chenshih881001/Life-Frog/Diagrams/Lifefrog Requirements Diagram.jpg

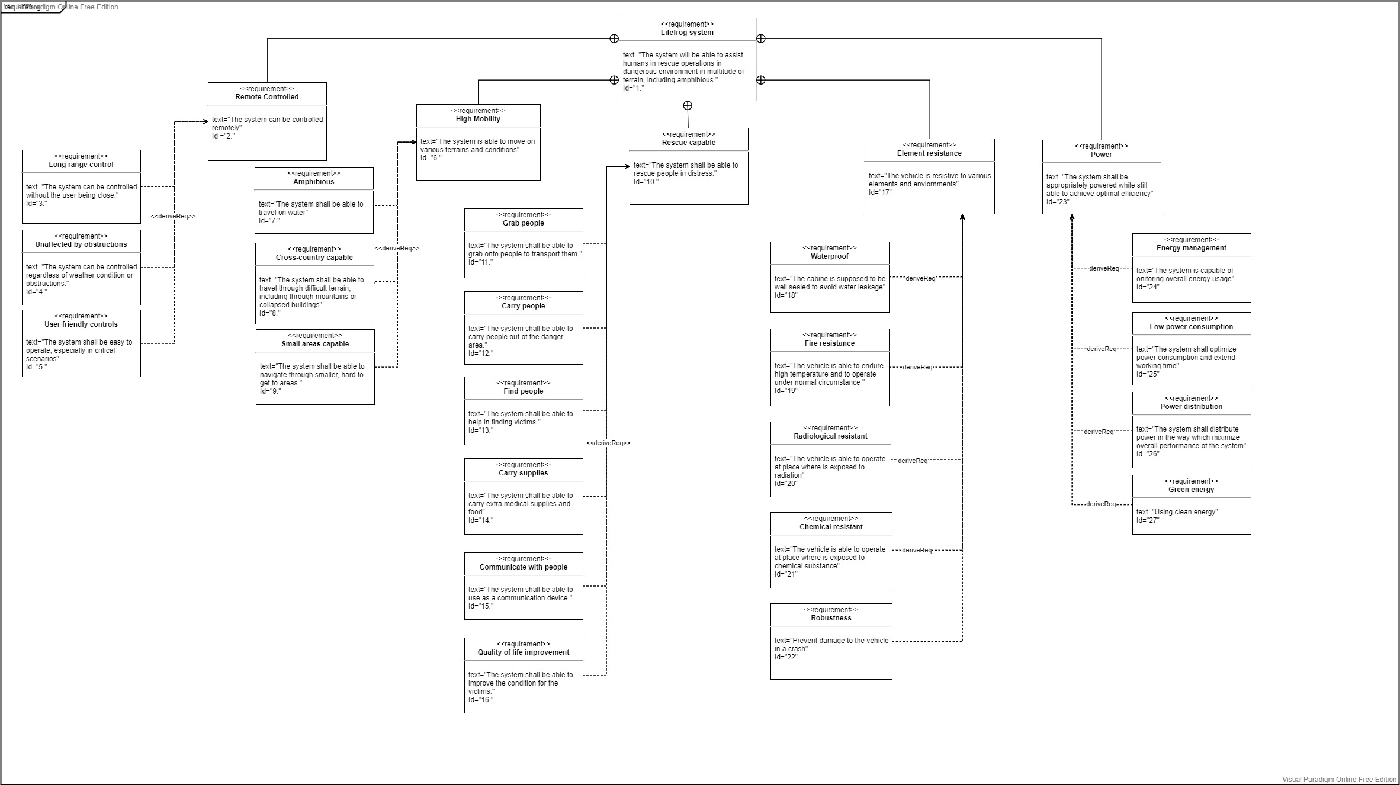
Diagrams/Lifefrog Requirements Diagram.jpg
