chenshih881001/Life-Frog/Diagrams/Lifefrog Sequence Diagram - Crane Control.png

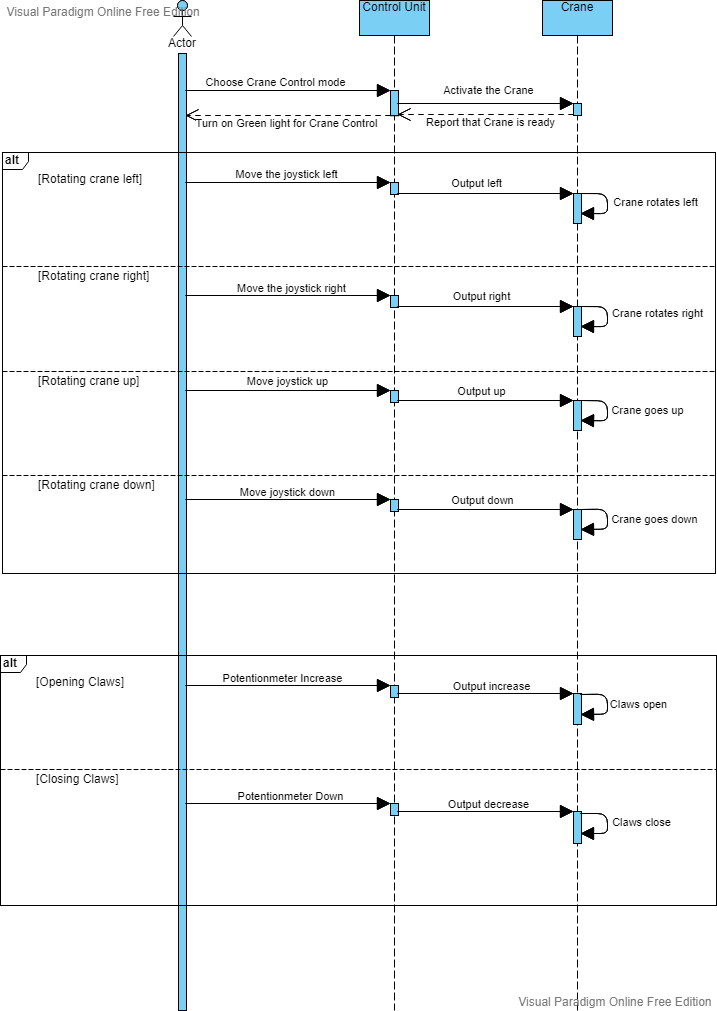
Diagrams/Lifefrog Sequence Diagram - Crane Control.png
