chenshih881001/Life-Frog/Diagrams/LifeFrog Sequence Diagram - Navigation.png

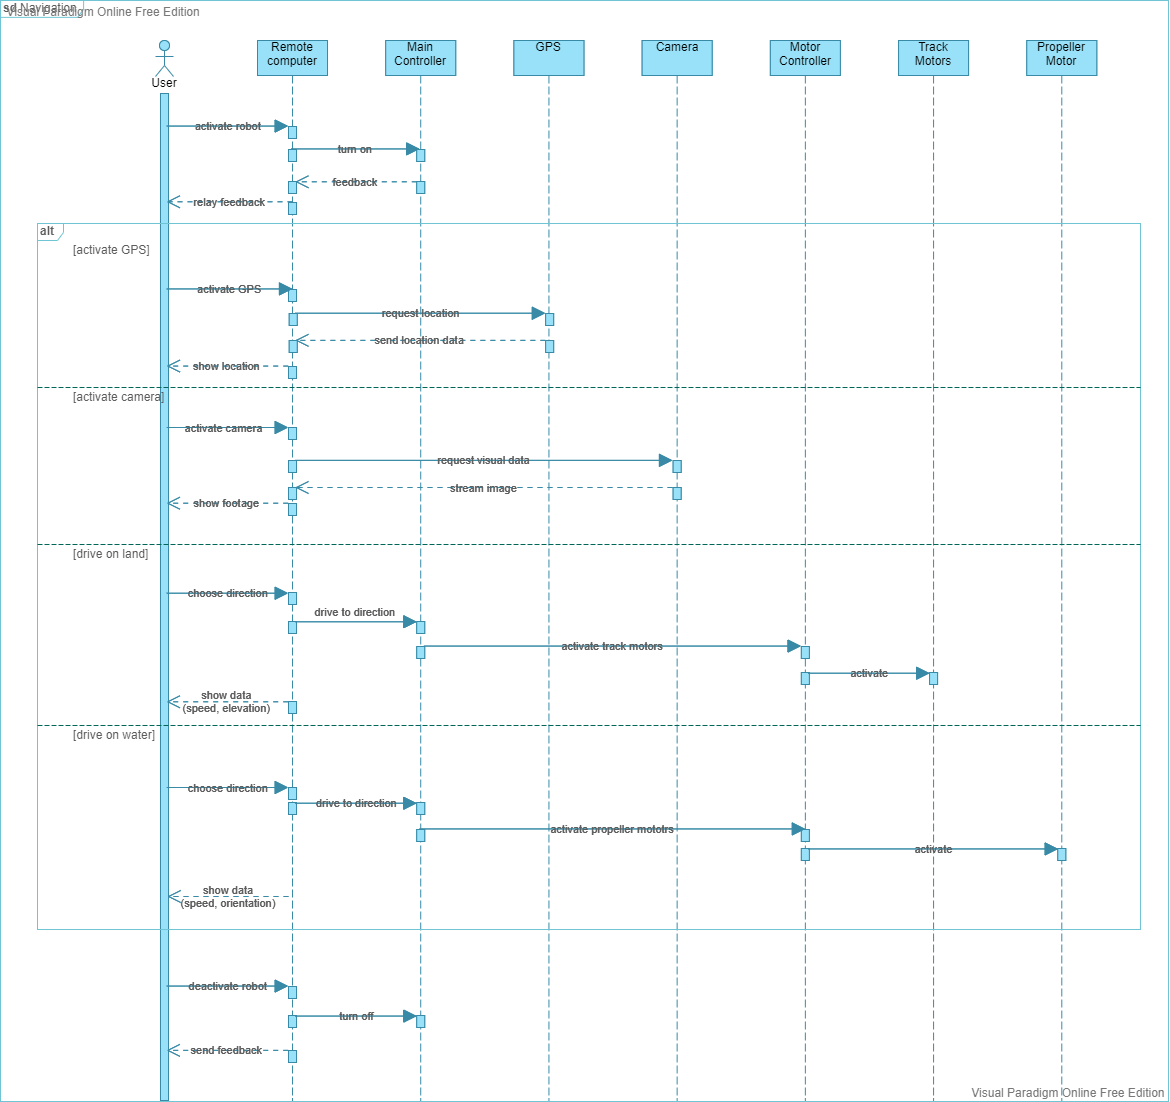
Diagrams/LifeFrog Sequence Diagram - Navigation.png
