chenshih881001/Life-Frog/Diagrams/Use-case Crane,ladders.png

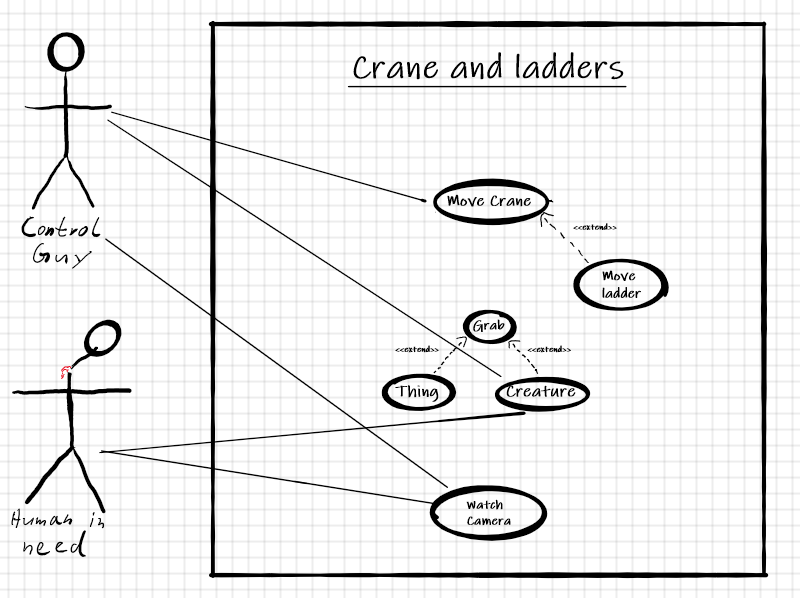
Diagrams/Use-case Crane,ladders.png
