chenshih881001/Life-Frog/Diagrams/Use-case Explorer robot.png

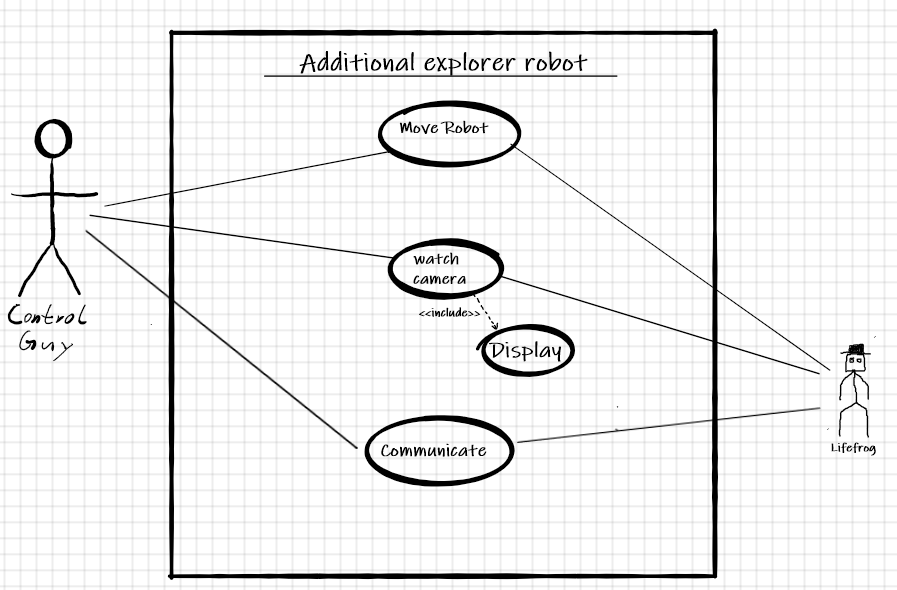
Diagrams/Use-case Explorer robot.png
