chenshih881001/Life-Frog/Diagrams/Use-case Remote control.png

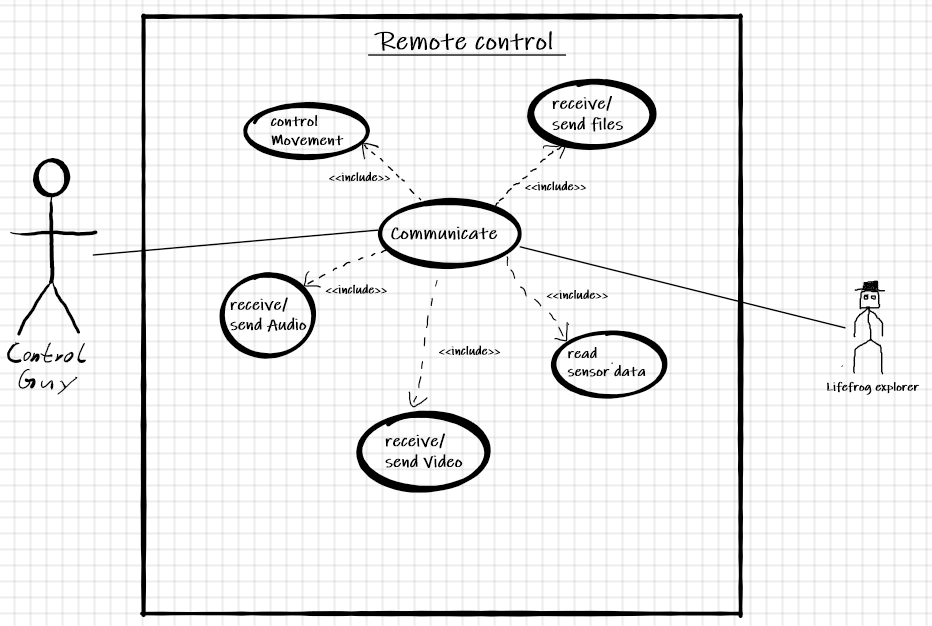
Diagrams/Use-case Remote control.png
