chenshih881001/Life-Frog/System engineering/Diagrams/Context diagram/LifeFrog - Block Diagram.png

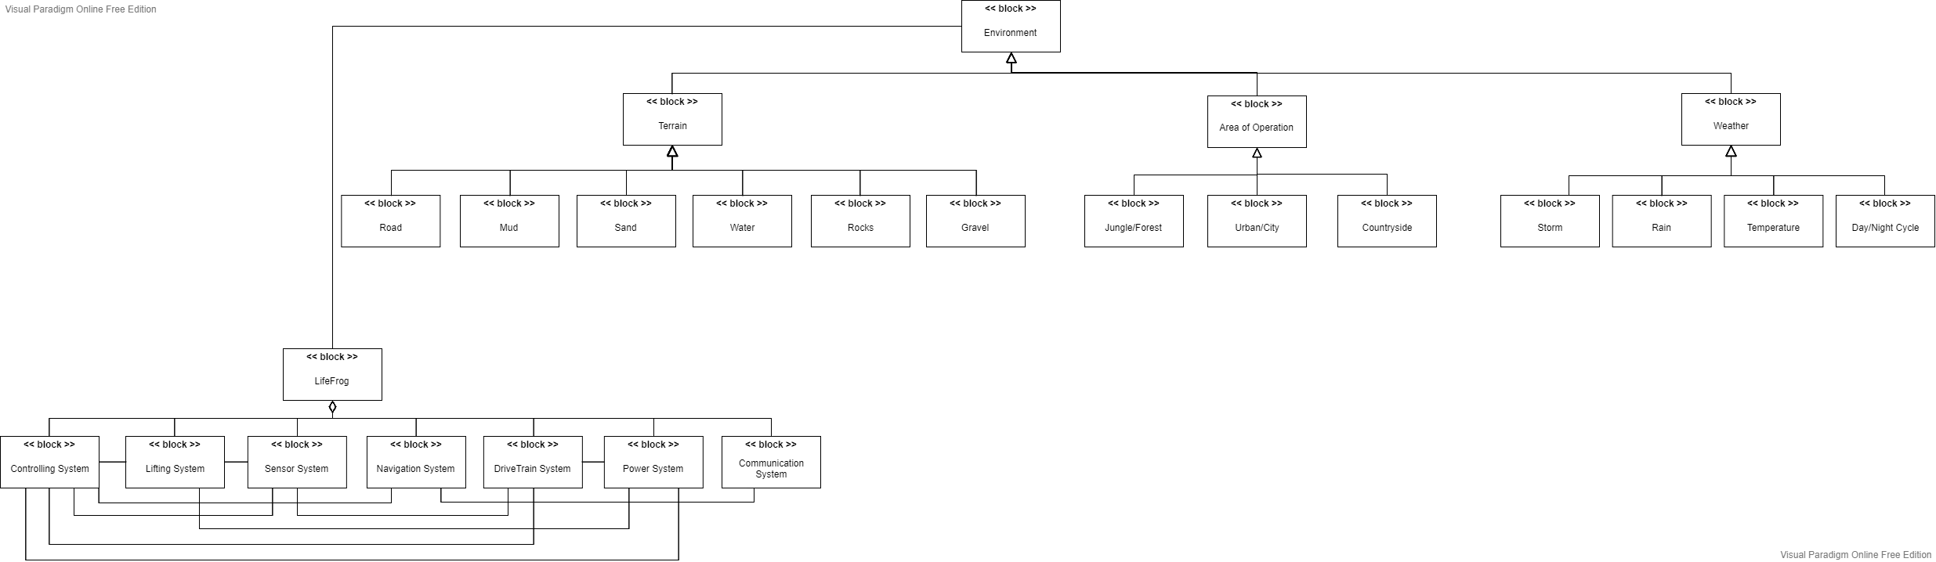
System engineering/Diagrams/Context diagram/LifeFrog - Block Diagram.png
