chenshih881001/Life-Frog/System engineering/Diagrams/Context diagram/Lifefrog - Constraints diag.png

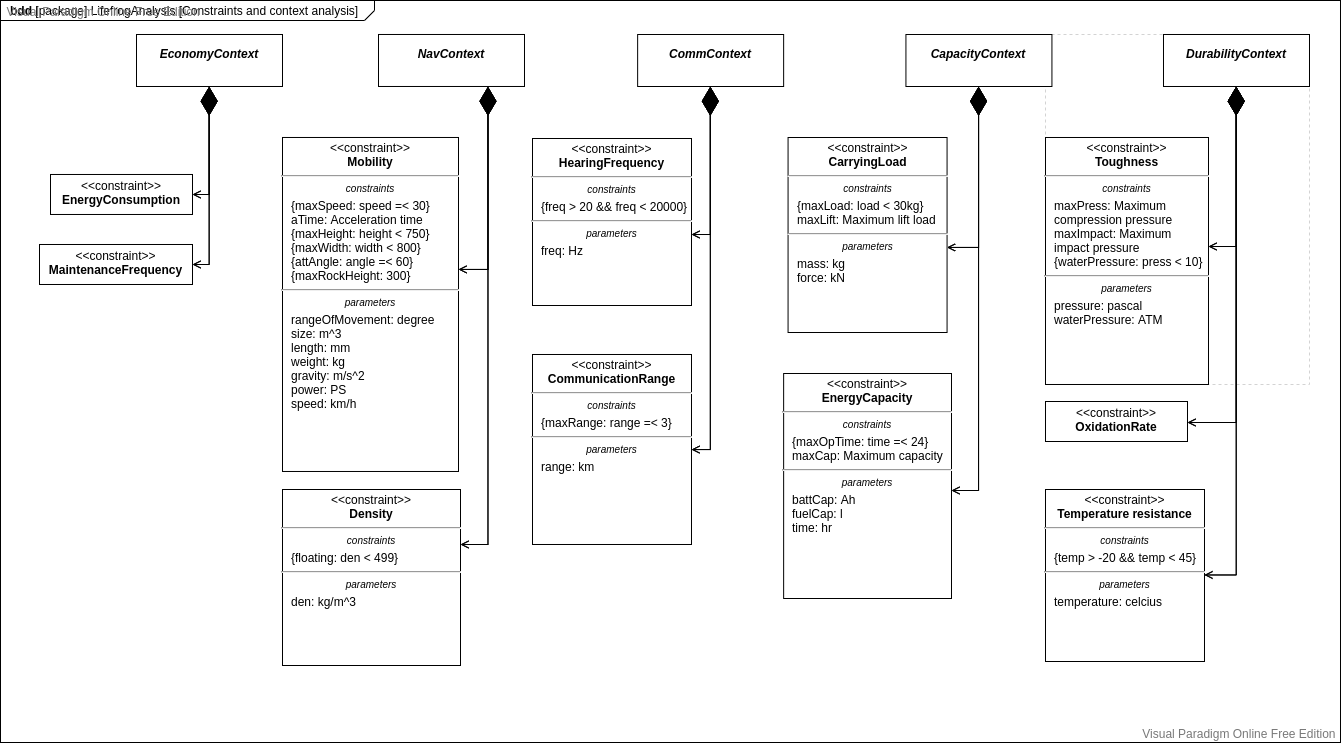
System engineering/Diagrams/Context diagram/Lifefrog - Constraints diag.png
