chenshih881001/Life-Frog/System engineering/Diagrams/Requirements/LifeFrog - Requirement Diagram.png

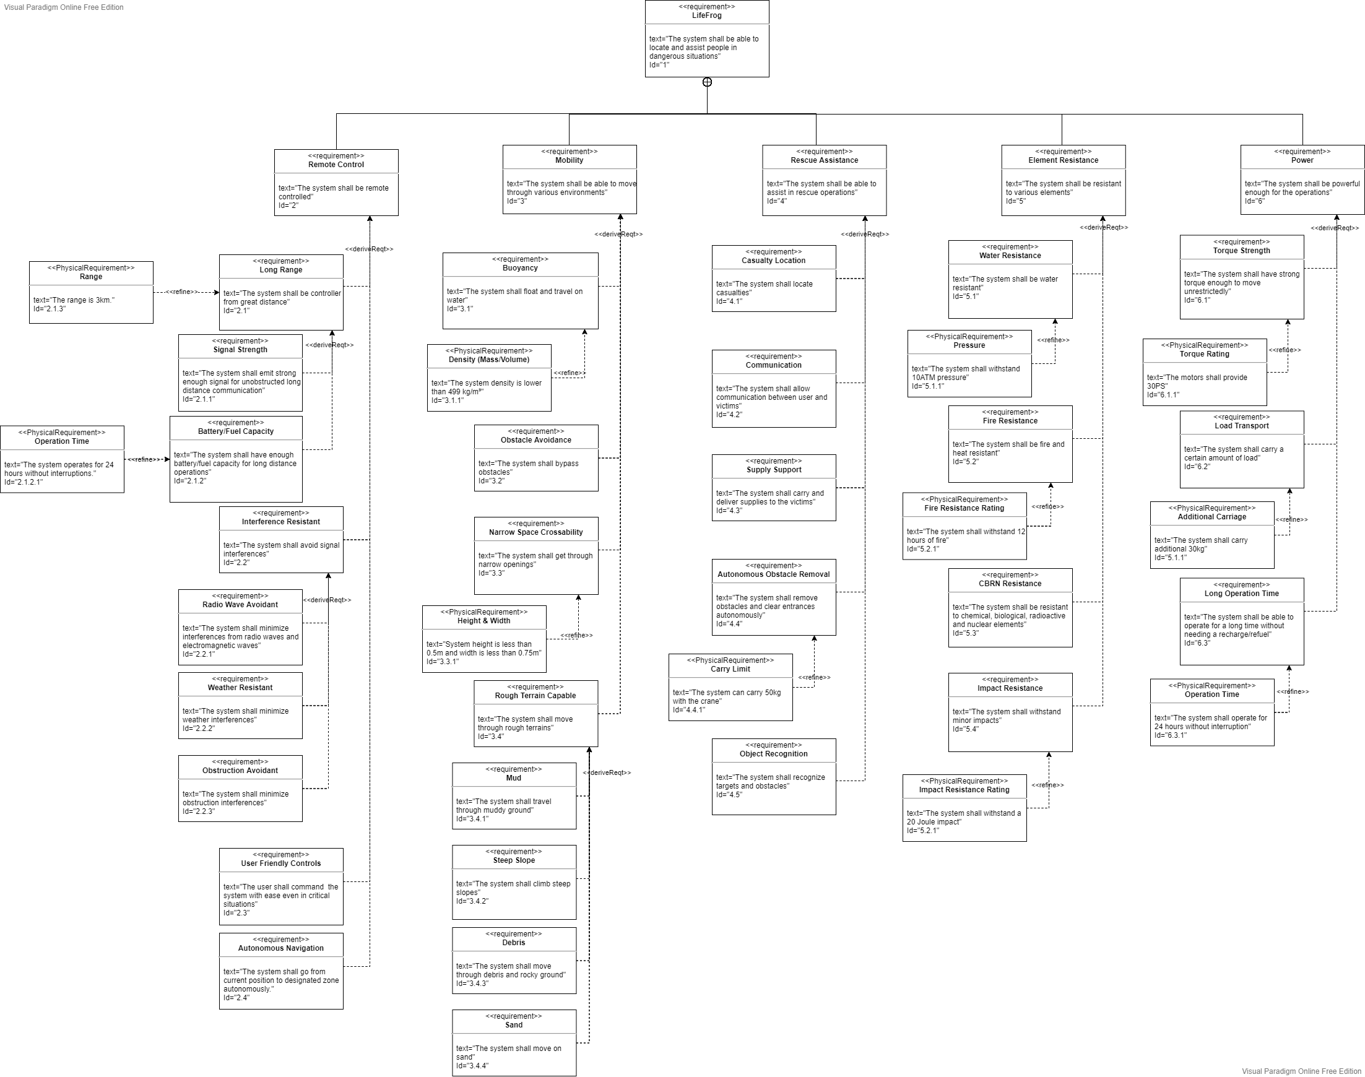
System engineering/Diagrams/Requirements/LifeFrog - Requirement Diagram.png
