chenshih881001/Life-Frog/System engineering/Diagrams/System structure/LifeFrog - Allocation Diagram.png

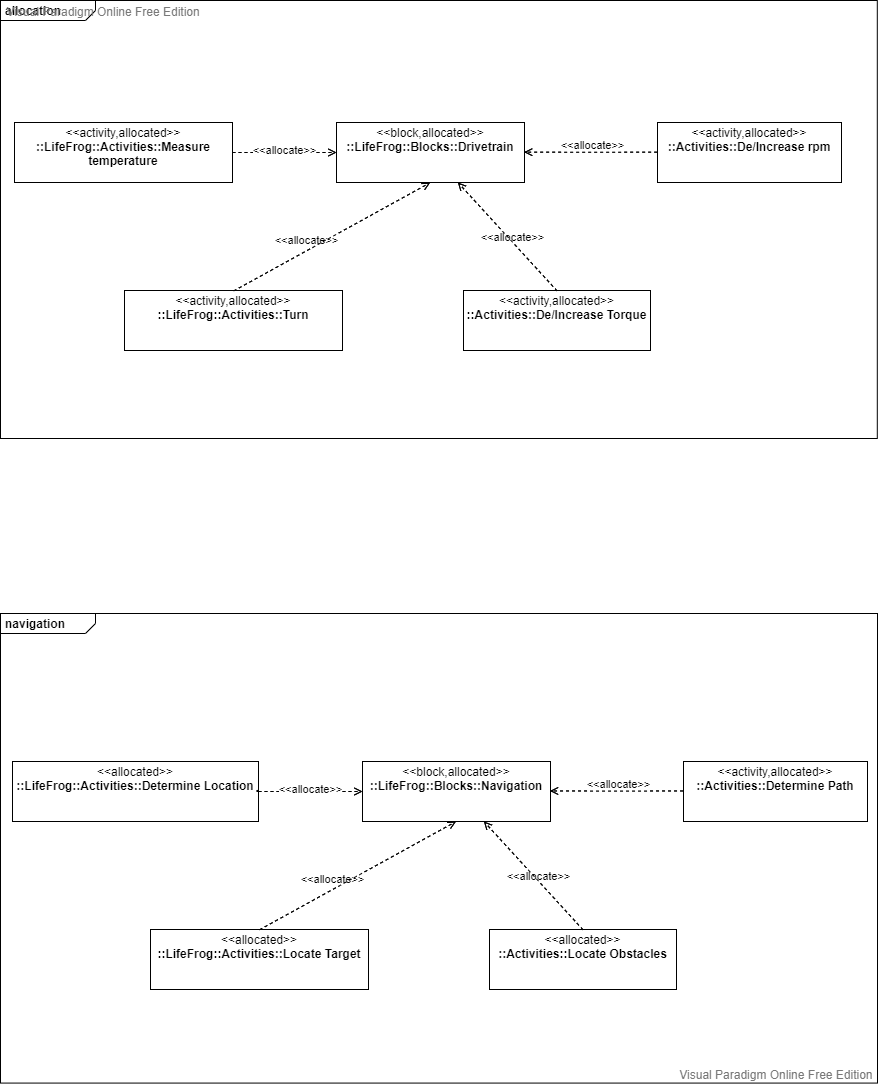
System engineering/Diagrams/System structure/LifeFrog - Allocation Diagram.png
