chenshih881001/Life-Frog/System engineering/Diagrams/System structure/LifeFrog - IDB Diagram for Drivetrain.png

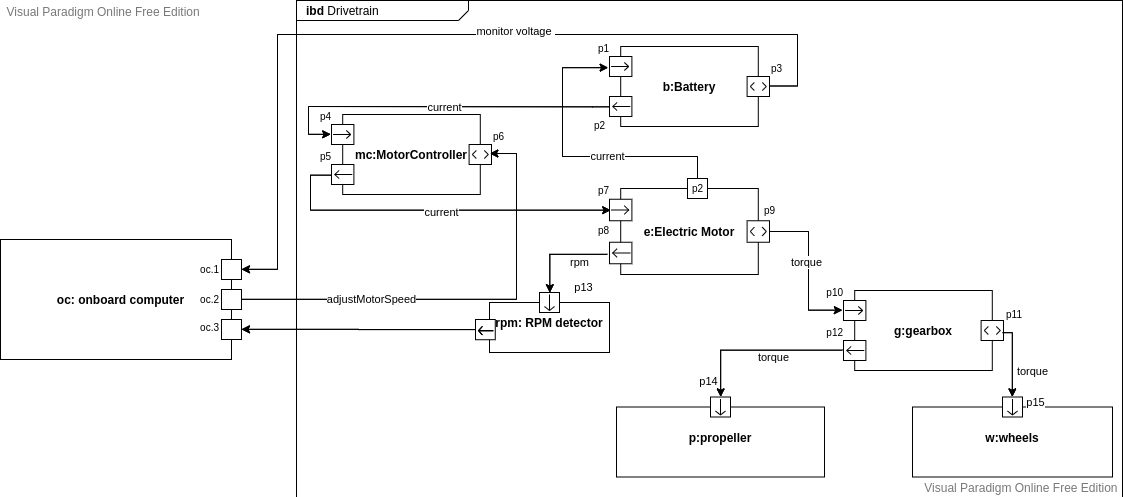
System engineering/Diagrams/System structure/LifeFrog - IDB Diagram for Drivetrain.png
