chenshih881001/Life-Frog/System engineering/Diagrams/System structure/Lifefrog - IDB.png

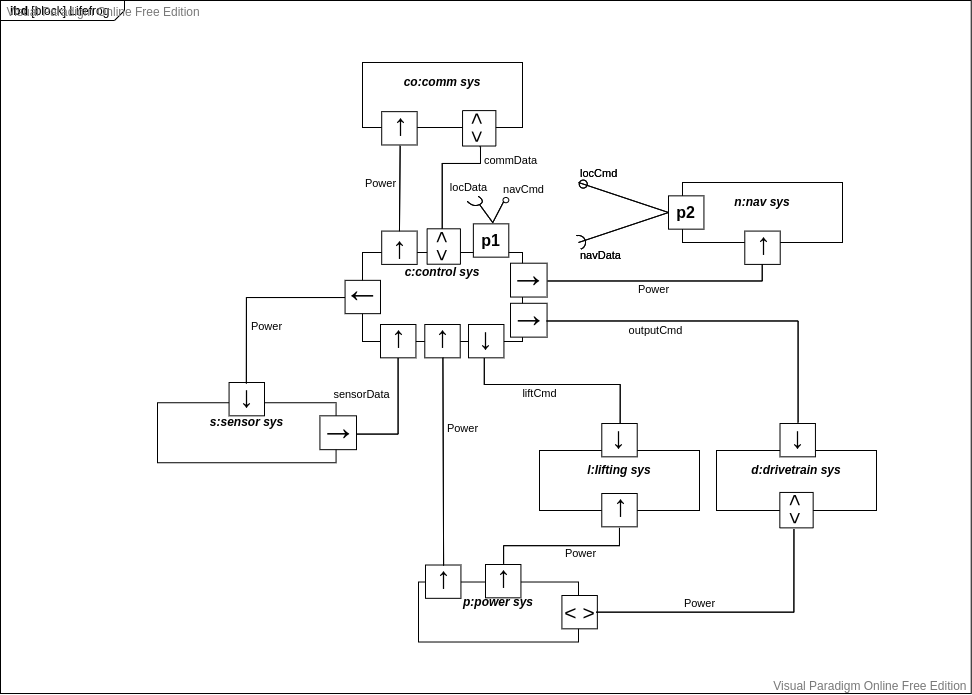
System engineering/Diagrams/System structure/Lifefrog - IDB.png
