chenshih881001/Life-Frog/System engineering/Diagrams/System structure/LifeFrog - Layered pattern.png

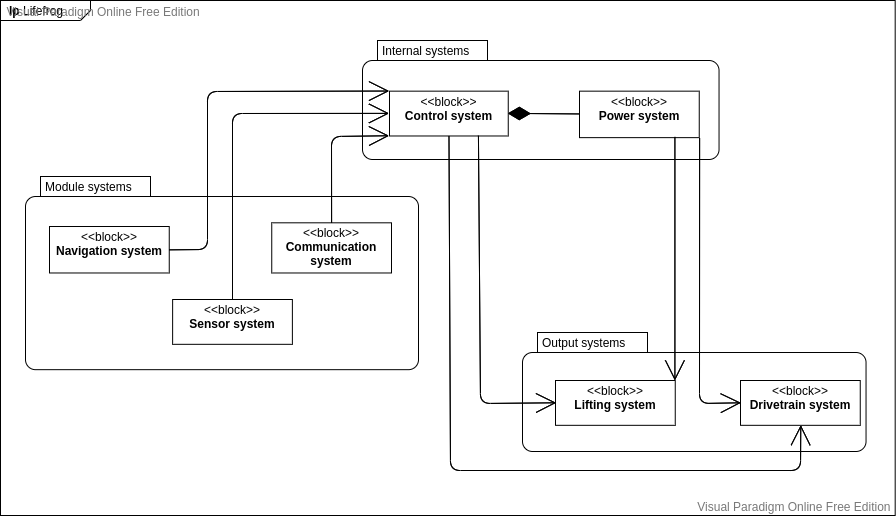
System engineering/Diagrams/System structure/LifeFrog - Layered pattern.png
