chenshih881001/Life-Frog/System engineering/Diagrams/Use case specification/LifeFrog - Activity Diagram.png

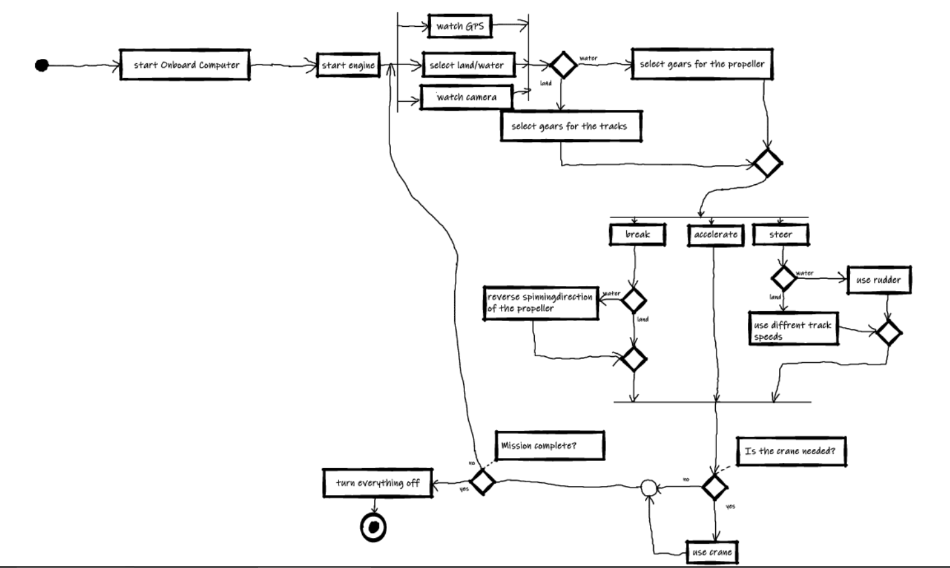
System engineering/Diagrams/Use case specification/LifeFrog - Activity Diagram.png
