chenshih881001/Life-Frog/System engineering/Diagrams/Use case specification/Lifefrog - use case diagram automated control.png

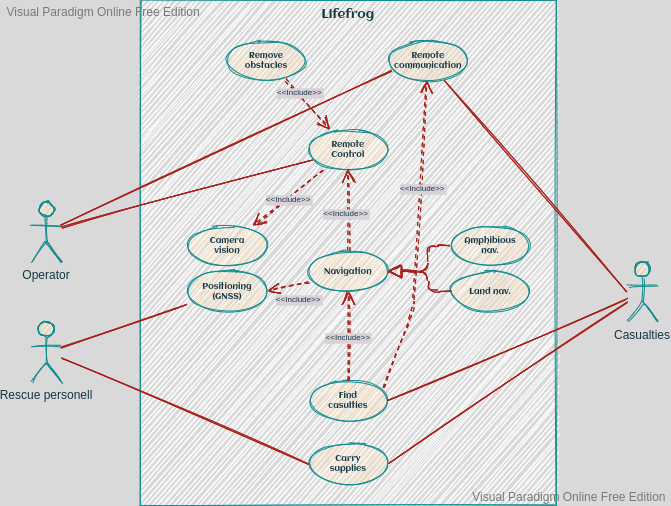
System engineering/Diagrams/Use case specification/Lifefrog - use case diagram automated control.png
