chenshih881001/Life-Frog/System engineering/Diagrams/Use case specification/LifeFrog Sequence Diagram [Automated].png

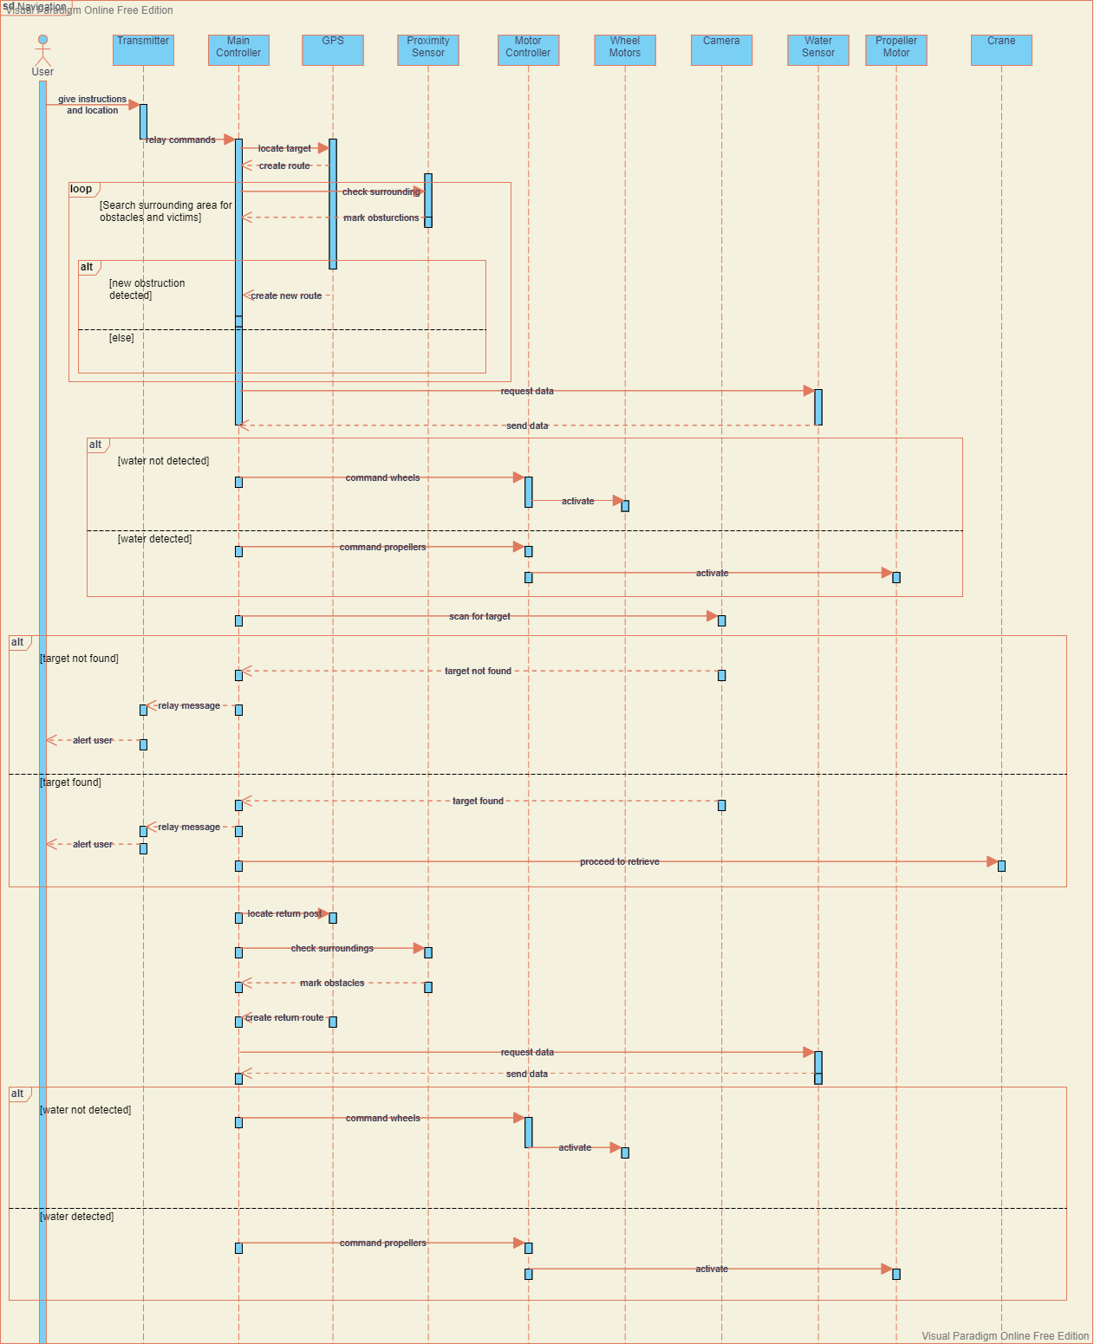
System engineering/Diagrams/Use case specification/LifeFrog Sequence Diagram [Automated].png
