chenshih881001/Life-Frog/System engineering/Paper design/Alex/Document_13_2.jpg

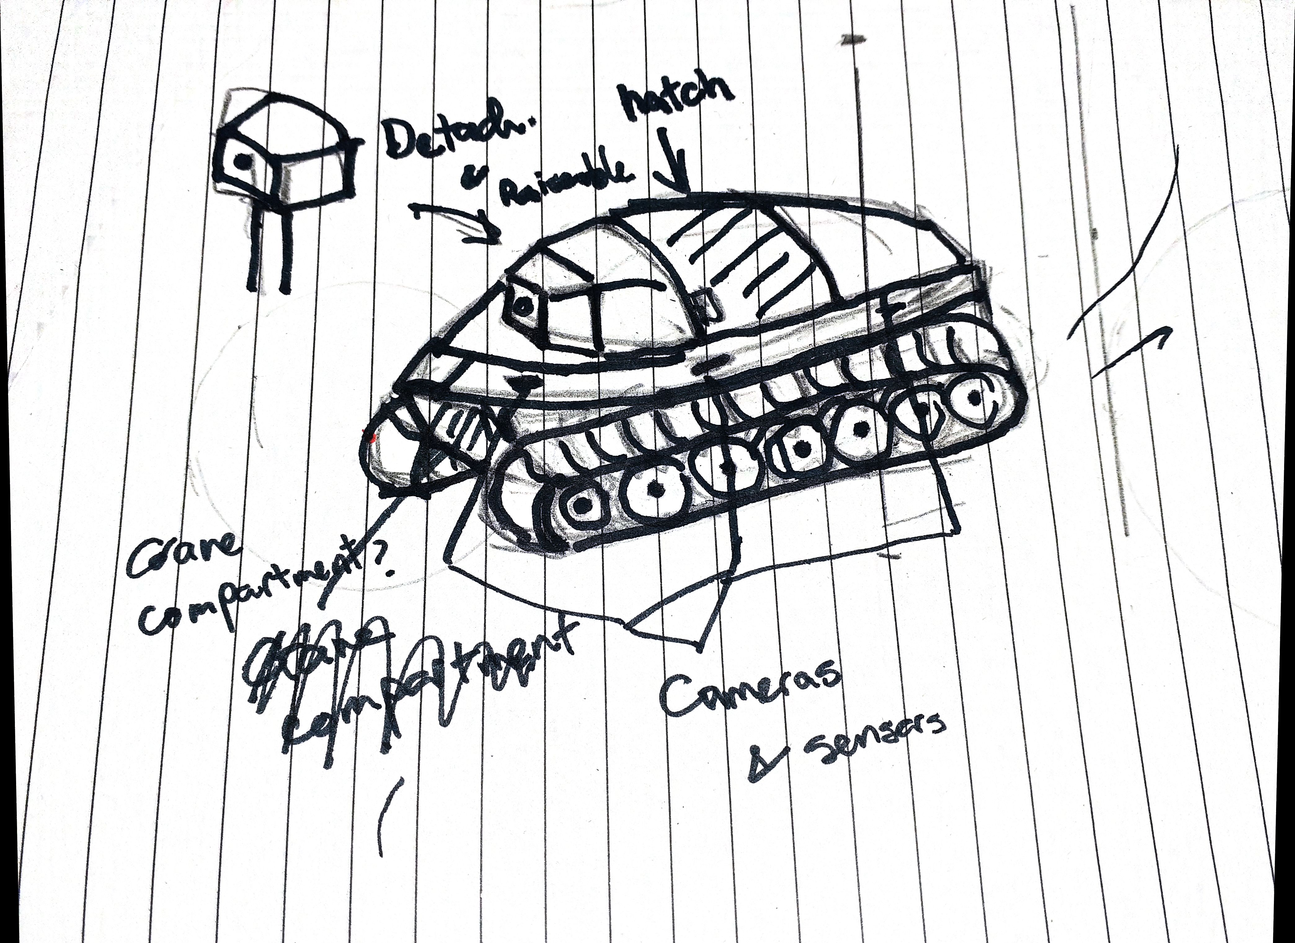
System engineering/Paper design/Alex/Document_13_2.jpg
