chenshih881001/Life-Frog/System engineering/Paper design/Alex/Document_13_3.jpg

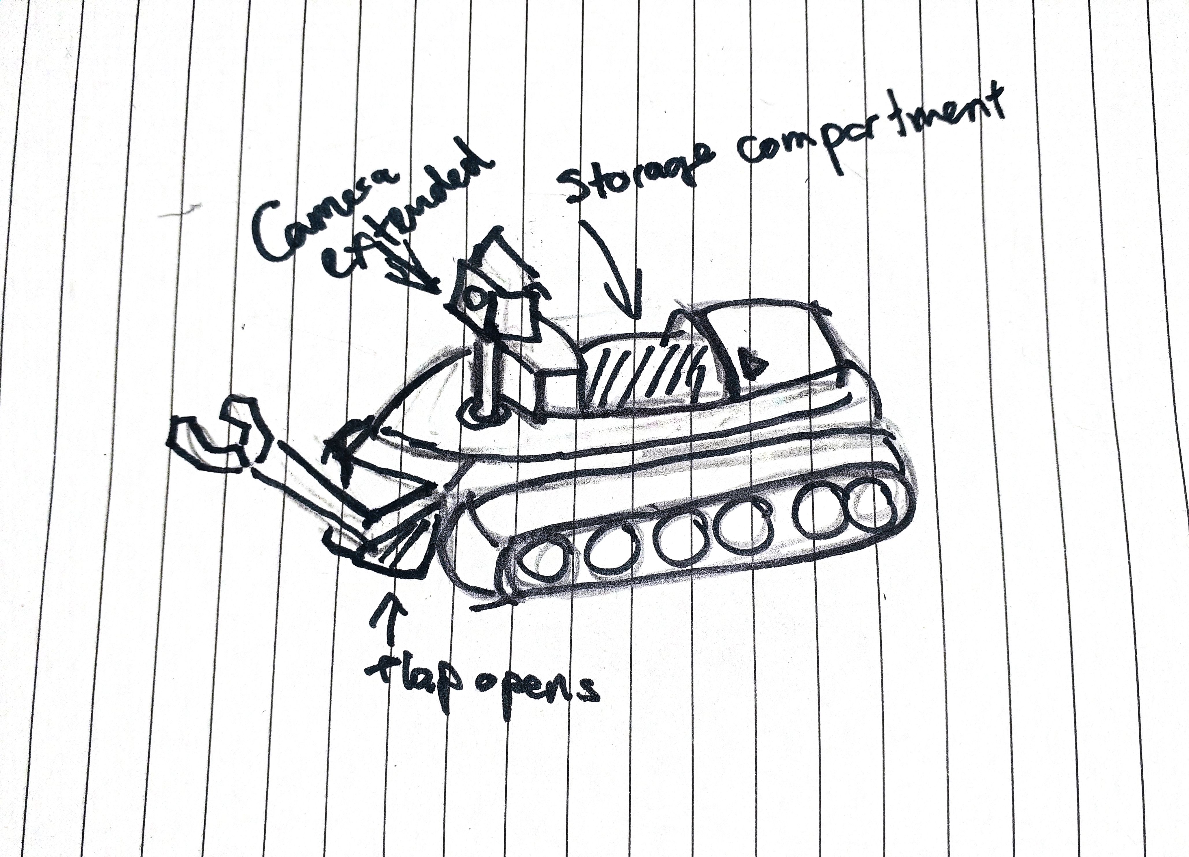
System engineering/Paper design/Alex/Document_13_3.jpg
