chenshih881001/Life-Frog/System engineering/Paper design/Alex/Prototype 2/Document_13_2.jpg

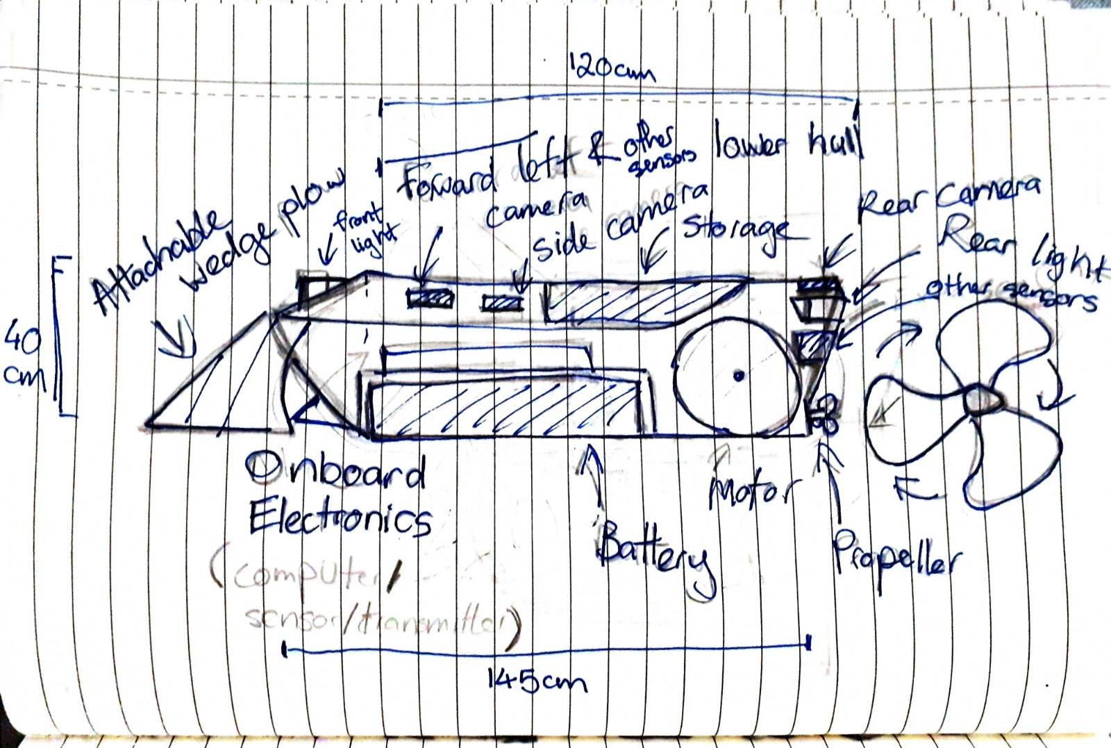
System engineering/Paper design/Alex/Prototype 2/Document_13_2.jpg
