chenshih881001/Life-Frog/System engineering/Paper design/Alex/Prototype 2/signal-2021-05-11-145407_003.jpeg

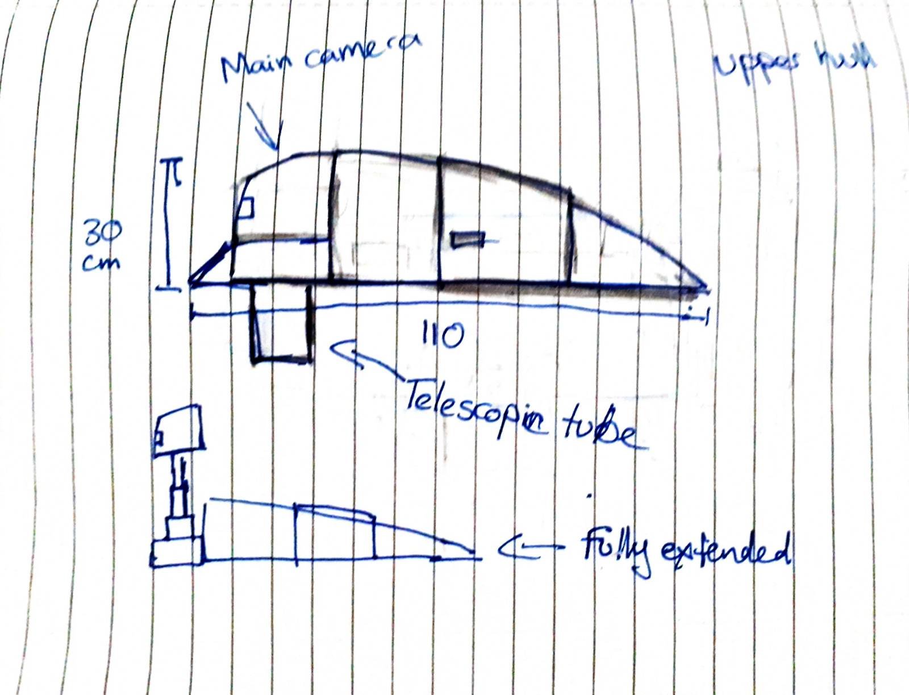
System engineering/Paper design/Alex/Prototype 2/signal-2021-05-11-145407_003.jpeg
