chenshih881001/Life-Frog/System engineering/Paper design/Christian/Christian-Concepts.PNG

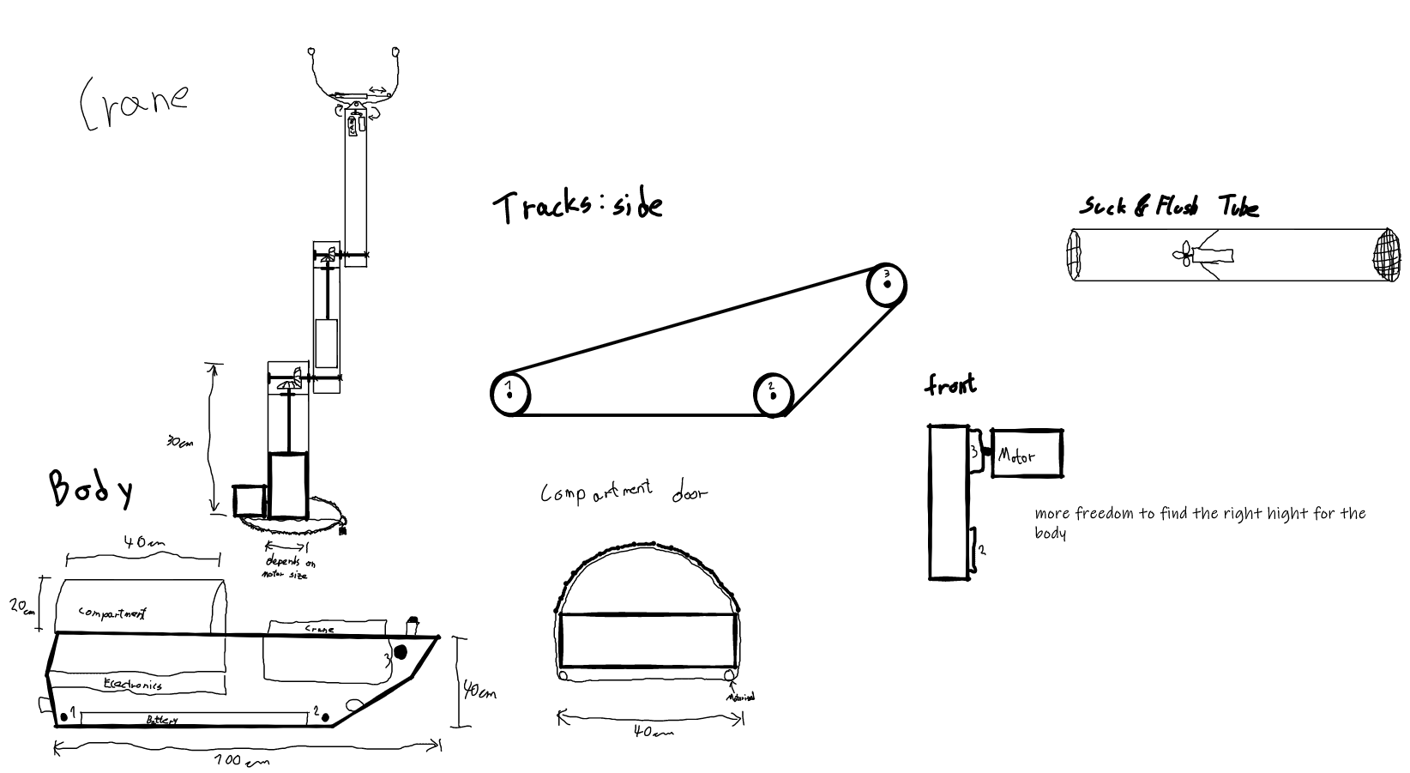
System engineering/Paper design/Christian/Christian-Concepts.PNG
