chenshih881001/Life-Frog/System engineering/Paper design/Christian/Christian-Design.PNG

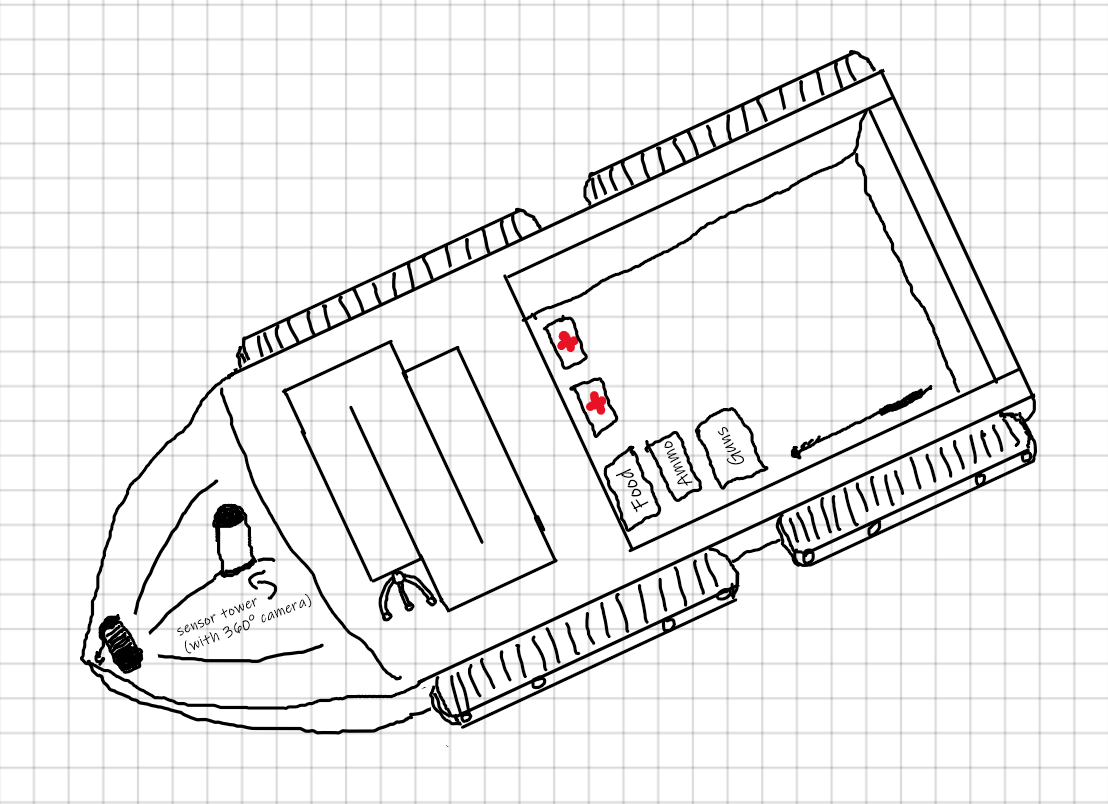
System engineering/Paper design/Christian/Christian-Design.PNG
