chenshih881001/Life-Frog/System engineering/Paper design/Final design/Bird eye view.png

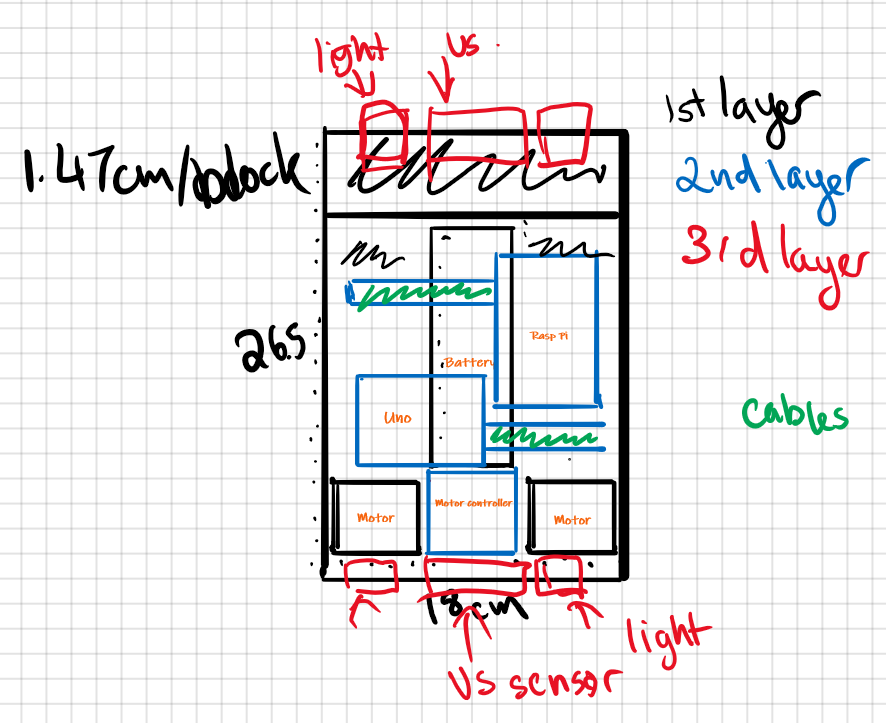
System engineering/Paper design/Final design/Bird eye view.png
