chenshih881001/Life-Frog/System engineering/Paper design/Final design/Hull design.png

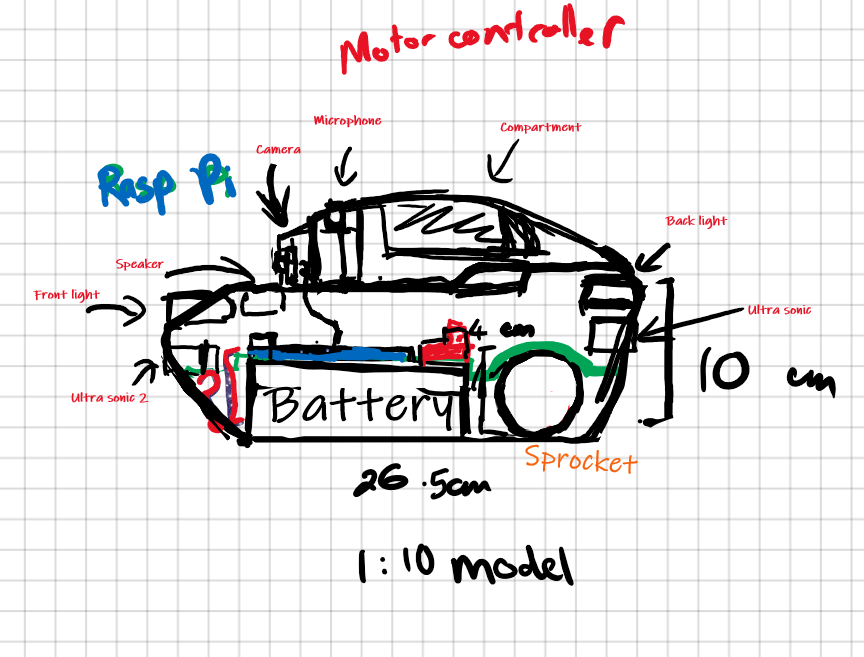
System engineering/Paper design/Final design/Hull design.png
