chenshih881001/Life-Frog/System engineering/Paper design/Final design/Tasks splitting.png

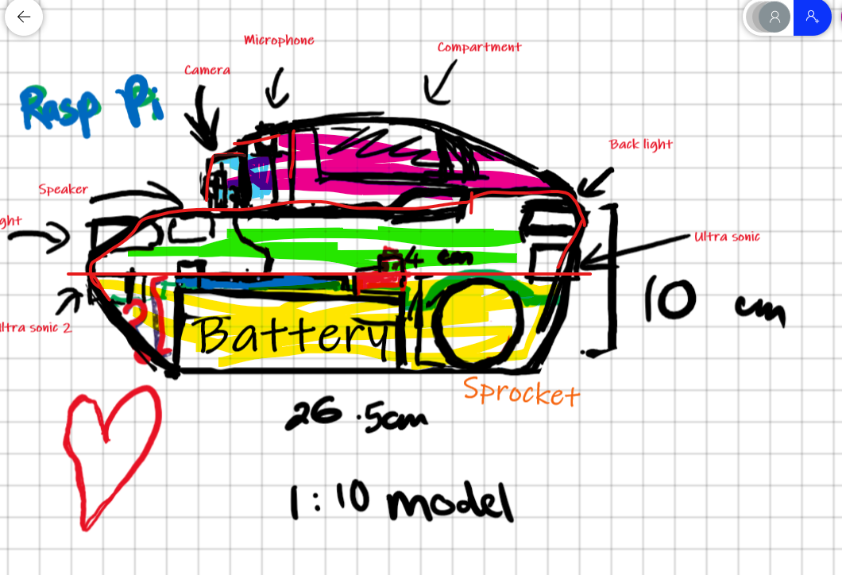
System engineering/Paper design/Final design/Tasks splitting.png
