chenshih881001/Life-Frog/System engineering/Paper design/Final design/Tracks design.png

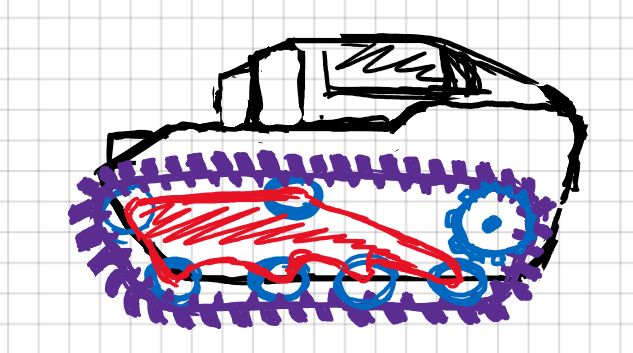
System engineering/Paper design/Final design/Tracks design.png
