chenshih881001/Life-Frog/System engineering/Paper design/Long/sketch-343.png

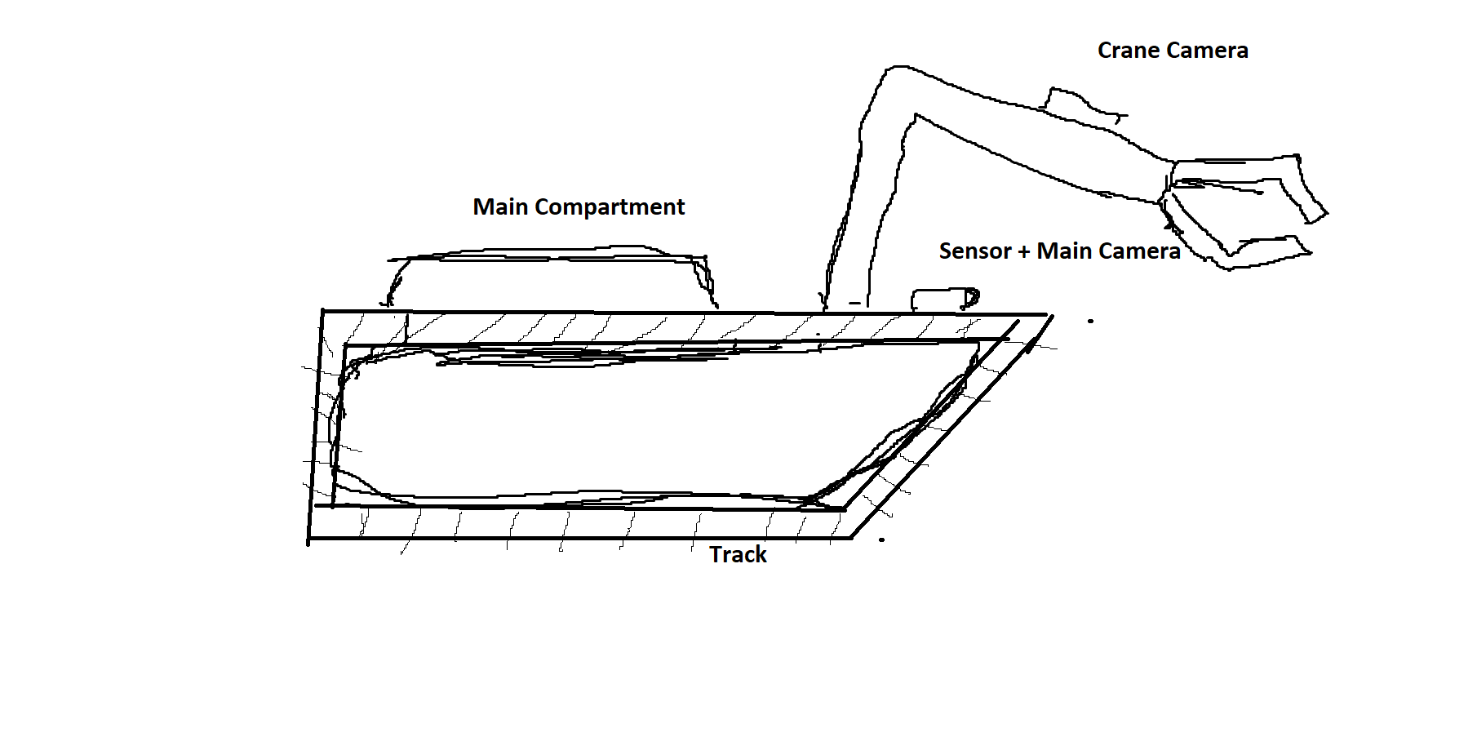
System engineering/Paper design/Long/sketch-343.png
