chenshih881001/Life-Frog/System engineering/Paper design/Niko/unknown.png

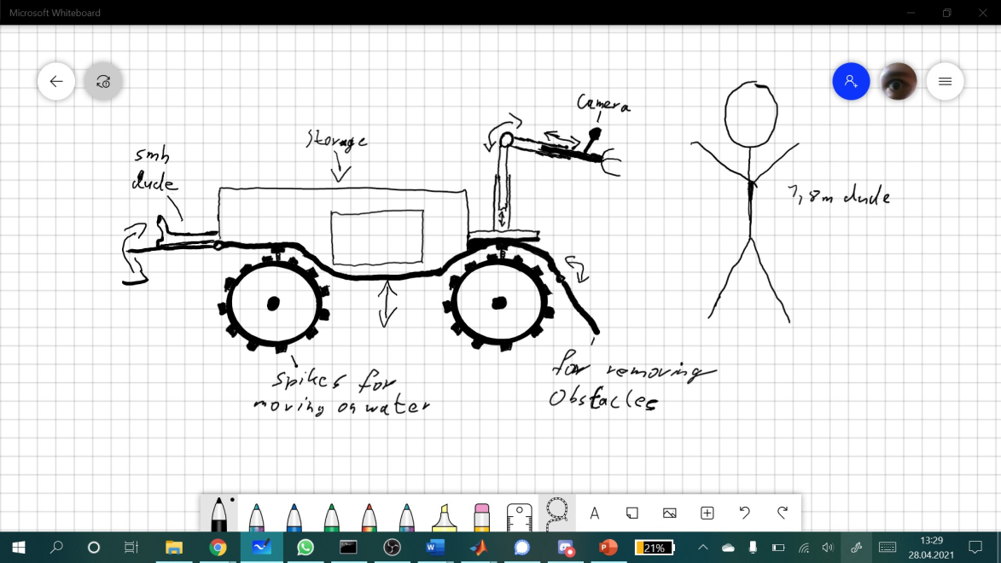
System engineering/Paper design/Niko/unknown.png
