chenshih881001/Life-Frog/System engineering/Paper design/Oscar/image0.jpg

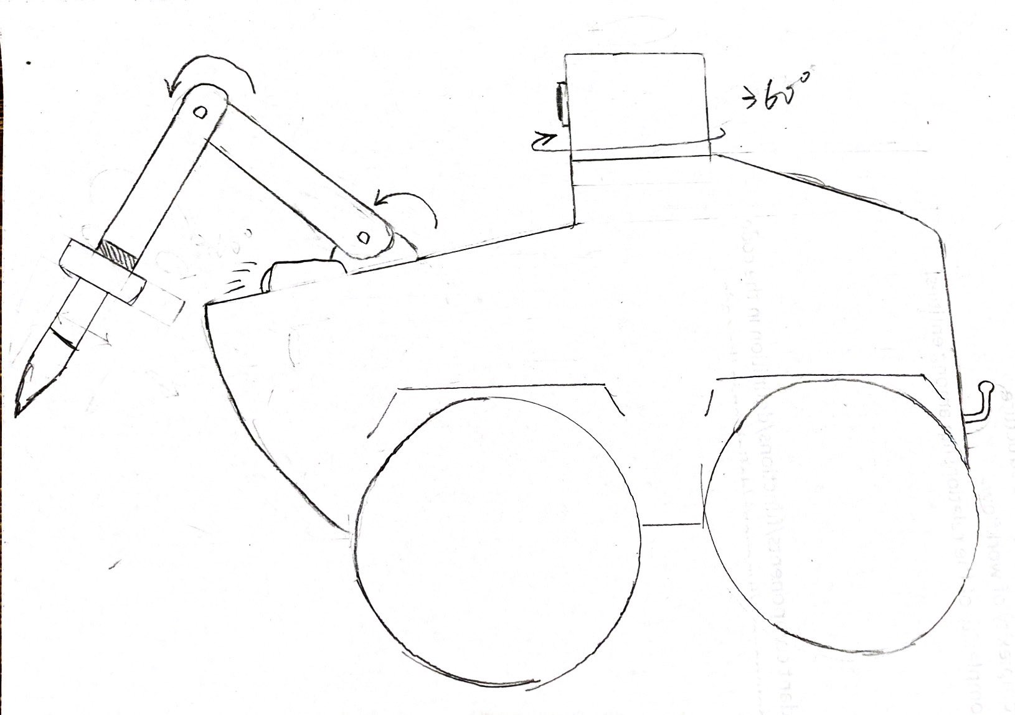
System engineering/Paper design/Oscar/image0.jpg
