chenshih881001/Life-Frog/System engineering/Paper design/Oscar/image1.jpg

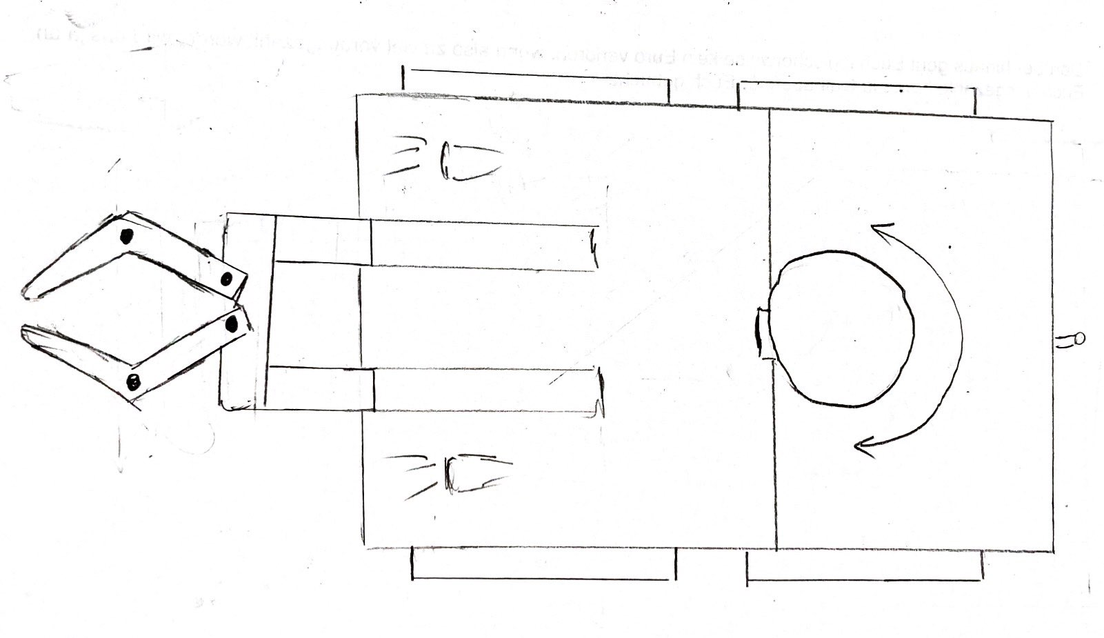
System engineering/Paper design/Oscar/image1.jpg
