chenshih881001/Life-Frog/System engineering/Paper design/Sam/Hovercraft concept.png

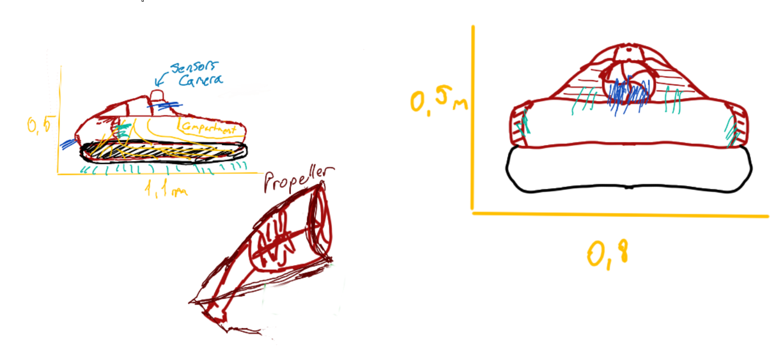
System engineering/Paper design/Sam/Hovercraft concept.png
