chenshih881001/Life-Frog/System engineering/Paper design/Sam/Sam- Design.png

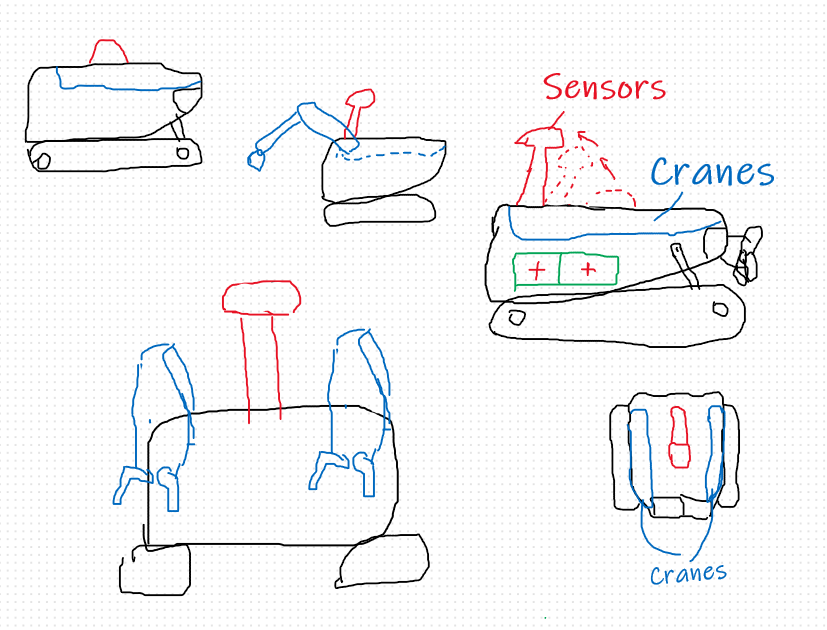
System engineering/Paper design/Sam/Sam- Design.png
