chenshih881001/Life-Frog/Prototype/Part list.xlsx

Name | Type | Price | Link | Note | Amount | Alt Part Name | Alt vendor
Shoulder Bolts | Screw (07534-06X40) | 0.90/piece | https://www.norelem.de/de/en/Products/Product-overview/Flexible-standard-component-system/Connecting-elements-ball-end-thrust-screws-and-baseplates-grub-screw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 | For the Idlers and Rollers | 15 | 7379-6-M5-40 | https://www.boie.de/mechanik/normelemente/befestigungs-und-positionierelemente/augenschrauben-passschrauben-druckschrauben/iso-7379-passschrauben/7379-6-m5-40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
Shoulder screw nuts | M5 DIN439 (Galvanised) | 1.29/pack of 100 | https://www.conrad.de/de/p/toolcraft-106996-sechskantmuttern-m5-din-439-stahl-galvanisch-verzinkt-gelb-chromatisiert-100-st-106996.html | For the Idlers and Rollers + Corrosion Resistance | 1 | M5 Nuts
Bolt | M2.5 16mm DIN 7985 | 4.79/pack of 200 | https://www.conrad.de/de/p/toolcraft-145895-linsenschrauben-m2-5-16-mm-kreuzschlitz-phillips-din-7985-stahl-galvanisch-verzinkt-200-st-145895.html | For mounting controllers + Corrosion Resistance | 1 | M2.5 Bolts - 16mm
Bolt | M3 8mm DIN 7985 (Galvanised) | 6.33/pack of 200 | https://www.conrad.de/de/p/toolcraft-145901-linsenschrauben-m3-8-mm-kreuzschlitz-phillips-din-7985-stahl-galvanisch-verzinkt-200-st-145901.html | For mounting side panels | 1 | M3 Bolts - 8mm
Nut | M2.5 DIN439 | 4.49/pack of 100 | https://www.conrad.de/de/p/toolcraft-106856-sechskantmuttern-m2-5-din-439-stahl-100-st-106856.html | For mounting controllers | 1 | M2.5 Nuts
Nut | M3 DIN439 Stainless | 3.79/pack of 100 | https://www.conrad.de/de/p/toolcraft-1060794-sechskantmuttern-m3-din-439-edelstahl-a4-100-st-1060794.html | For mounting side panels + Corrosion Resistance | 1 | M3 Nuts
Bolt | M2 5mm DIN 7985 | 2.36/pack of 100 | https://www.conrad.de/de/p/toolcraft-827126-linsenschrauben-m2-5-mm-kreuzschlitz-phillips-din-7985-stahl-galvanisch-verzinkt-100-st-827126.html | For mounting Mic + Camera | 1 | M2 Bolts - 5/6mm
Nut | M2 DIN439 | 4.79/pack of 100 | https://www.conrad.com/p/toolcraft-106855-hexagonal-nuts-m2-din-439-steel-100-pcs-106855 | For mounting Mic + Camera | 1 | M2 Nuts
Liquid rubber coating | Coating | 18.99/container | https://www.conrad.com/p/mibenco-pur-liquid-rubber-coating-colour-black-matt-72829005-175-g-1297872 | For increasing traction of tracks | 2021-01-02
Raspberry Pi | Microcontroller |  |  | For controlling camera | 1
Arduino Uno | Microcontroller |  |  | For controlling motors and sensors | 1
Raspberry Pi Camera | Camera |  |  | For computer vision | 1
Big Sound | Microphone |  |  | For voice | 1
Passive buzzer | Buzzer |  |  | Act as a speaker | 1
Ultra sonic sensor | Sensor |  |  | Detect things | 2
O'rings Set | Waterproofing | 11.99/set | https://www.conrad.de/de/p/toolcraft-to-6680046-o-ring-sortiment-inhalt-225-st-2226682.html | For waterproofing | 1
Axial bearings | Ball bearings | 5.99/piece | https://www.conrad.de/de/p/reely-rillenkugellager-axial-chromstahl-innen-durchmesser-6-mm-aussen-durchmesser-13-mm-drehzahl-max-10000-u-min-214531.html | For decreasing friction | 15
