chenshih881001/Life-Frog/Prototype/To print list.xlsx

Type | Name | Amount
Drive systems
 | Tracks | 2
 | Holder Left | 1
 | Holder Right | 1
 | Idler | 6
 | Roller | 6
 | Sprocket | 2
 | Sprocket Cap | 2
Body
 | Hull | 1
 | Mounting platform | 1
Top
 | Hood | 1
 | Compartment | 1
 | Compartment Door | 1
