chenshih881001/Life-Frog/Prototype/Parts/Body parts/1_Layer.SLDASM

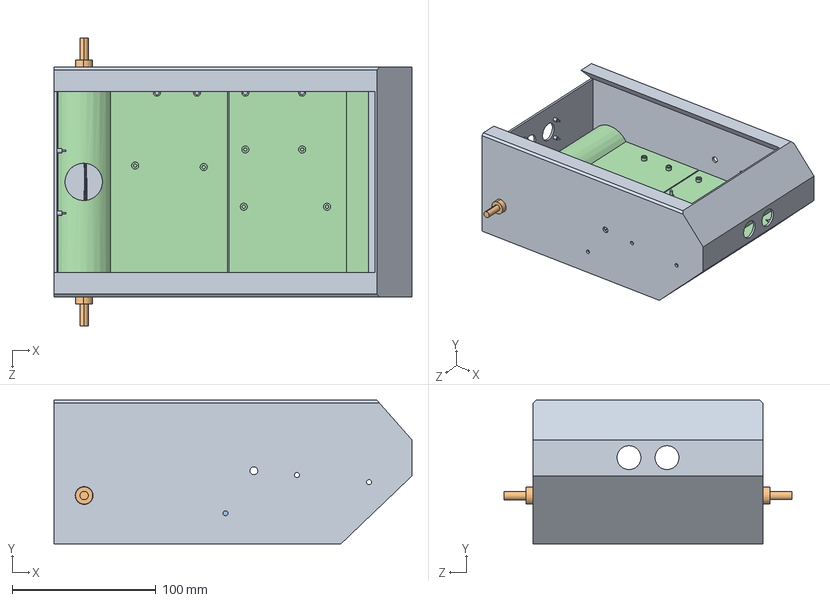
[picture p55: CAD file, 2021-05-28]
Prototype/Parts/Body parts/1_Layer.SLDASM
249.4 x 100.0 x 200.8 mm
motor.step x 2
Battery
Layer-2_Mounting
