chenshih881001/Life-Frog/Prototype/Parts/Top layer parts/Hood + Mic + Cam.SLDASM

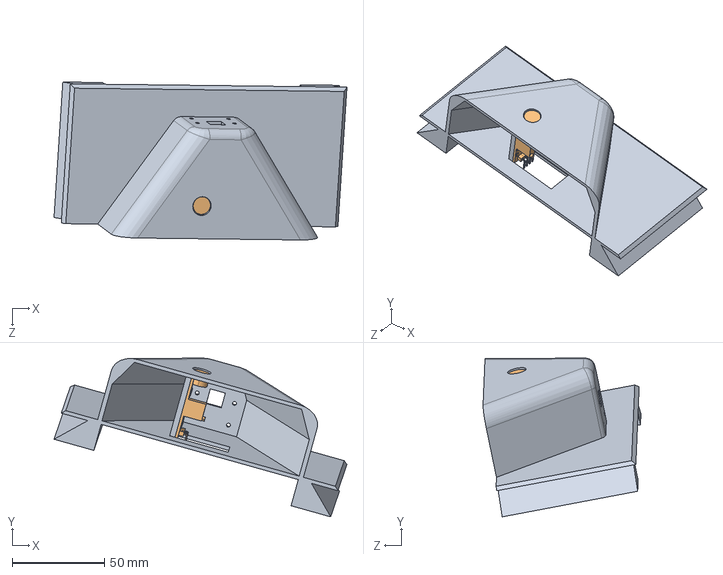
[picture p56: CAD file, 2021-05-28]
Prototype/Parts/Top layer parts/Hood + Mic + Cam.SLDASM
159.0 x 86.2 x 85.7 mm
Hood
Mic.step
