chenshih881001/Life-Frog/Prototype/Parts/Top layer parts/Assem3.SLDASM

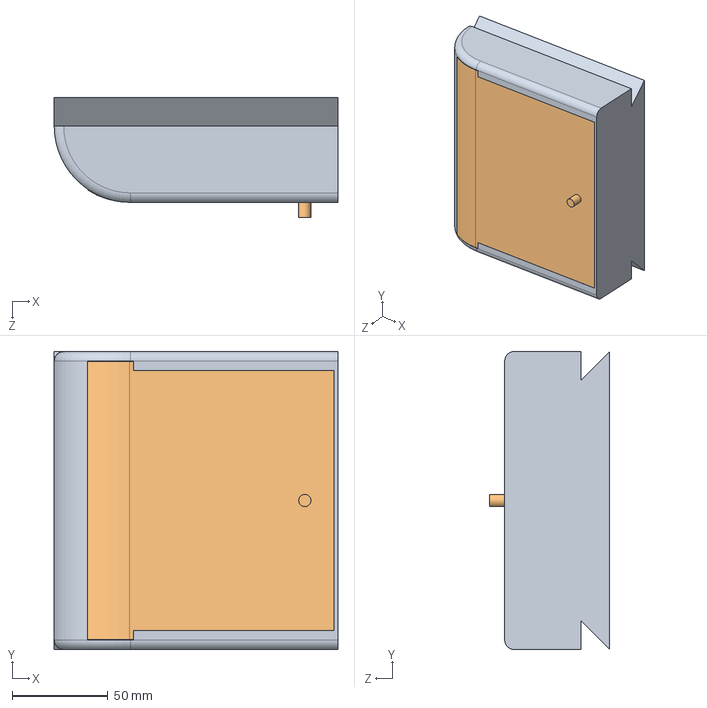
[picture p57: CAD file, 2021-05-28]
Prototype/Parts/Top layer parts/Assem3.SLDASM
148.5 x 156.0 x 63.0 mm
Compartment - No Tolerance
compartment door - No tolerance
