chenshih881001/Life-Frog/Prototype/Parts/Top layer parts/raspberry-pi-camera-3.snapshot.2/OVA5647.SLDASM

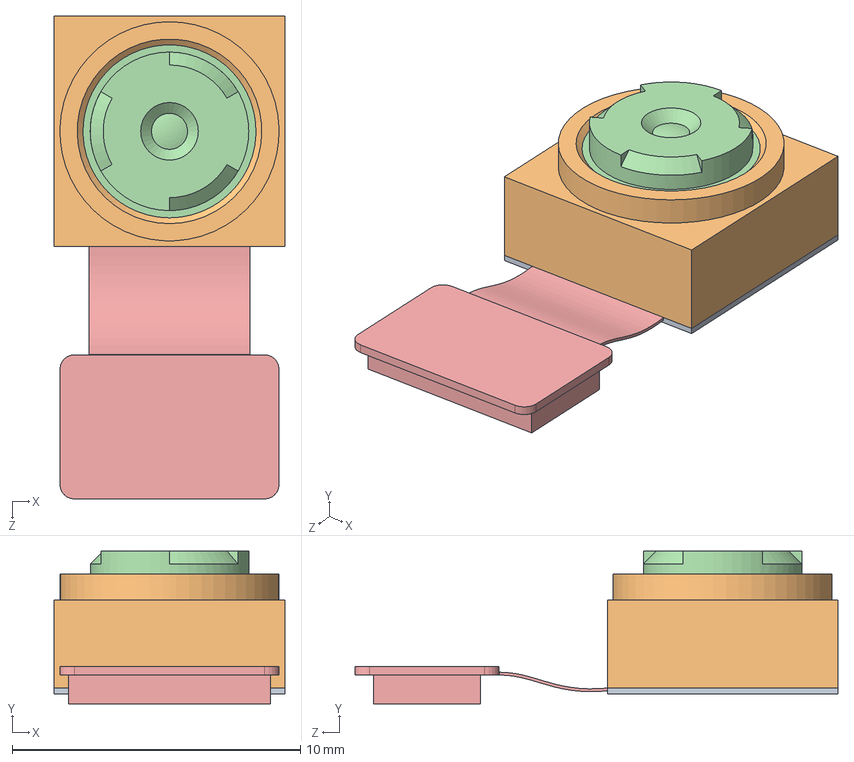
[picture p58: CAD file, 2021-05-28]
Prototype/Parts/Top layer parts/raspberry-pi-camera-3.snapshot.2/OVA5647.SLDASM
8.00 x 5.30 x 16.8 mm
OVA5647
OVA5647_Housing
OVA5647_IR-Glas
OVA5647_Lens
OVA5647_Pigtail
