chenshih881001/Life-Frog/Prototype/Parts/Body parts/Arduino R3 UNO/uno.SLDASM

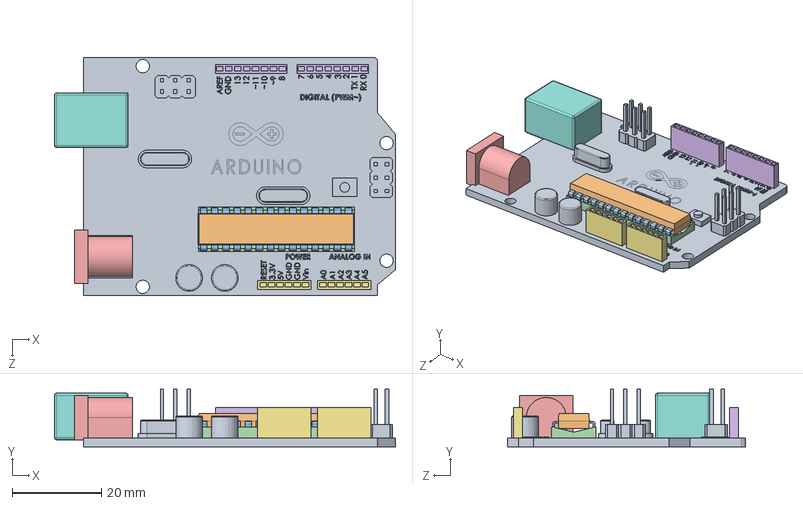
[picture p59: CAD file, 2021-05-26]
Prototype/Parts/Body parts/Arduino R3 UNO/uno.SLDASM
76.5 x 13.0 x 53.5 mm
Arduino board
IC body
IC pin x 28
IC socket
Jack Socket
pin x 2
pin2 x 2
USB socket
