chenshih881001/Life-Frog/Prototype/Parts/Body parts/Arduino R3 UNO/IC.SLDASM

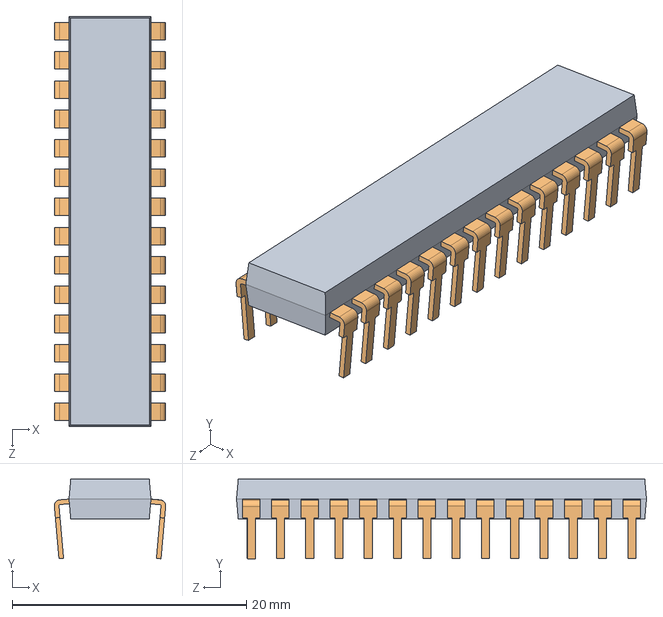
[picture p60: CAD file, 2021-05-26]
Prototype/Parts/Body parts/Arduino R3 UNO/IC.SLDASM
9.50 x 6.80 x 35.0 mm
IC body
IC pin x 28
