chenshih881001/Life-Frog/Prototype/Parts/Track parts/Box for Tracks.SLDASM

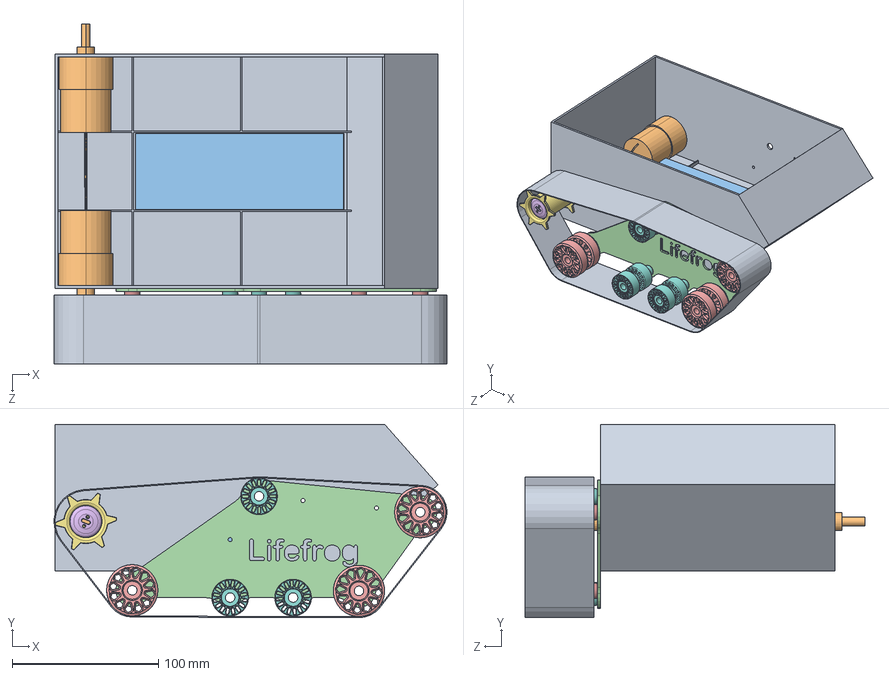
[picture p61: CAD file, 2021-05-24]
Prototype/Parts/Track parts/Box for Tracks.SLDASM
268.3 x 132.1 x 231.8 mm
motor.step x 2
Battery
Holder final Opposite
Idler v.1.2 x 3
Sprocket Cap
Sprocket Final
Roller v.1.2 x 3
Belt1-3
