chenshih881001/Life-Frog/Prototype/Parts/Track parts/Sprocket and cap.SLDASM

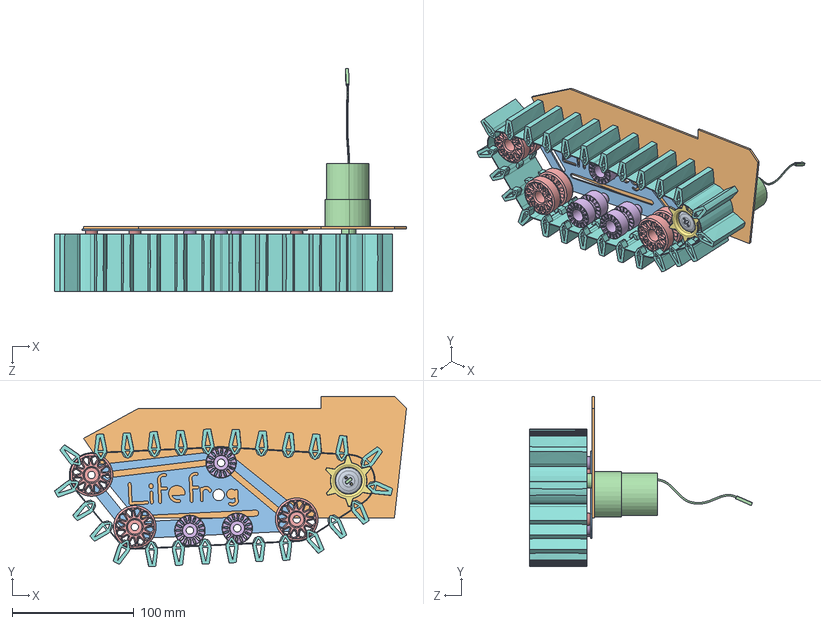
[picture p62: CAD file, 2021-05-23]
Prototype/Parts/Track parts/Sprocket and cap.SLDASM
288.8 x 139.7 x 182.8 mm
Sprocket Cap
trial side
Holder
motor.step
Idler v.1.2 x 3
Roller v.1.2 x 3
Sprocket2
Belt1-1
