chenshih881001/Life-Frog/Prototype/Parts/Body parts/Arduino R3 UNO/Arduino board.SLDPRT

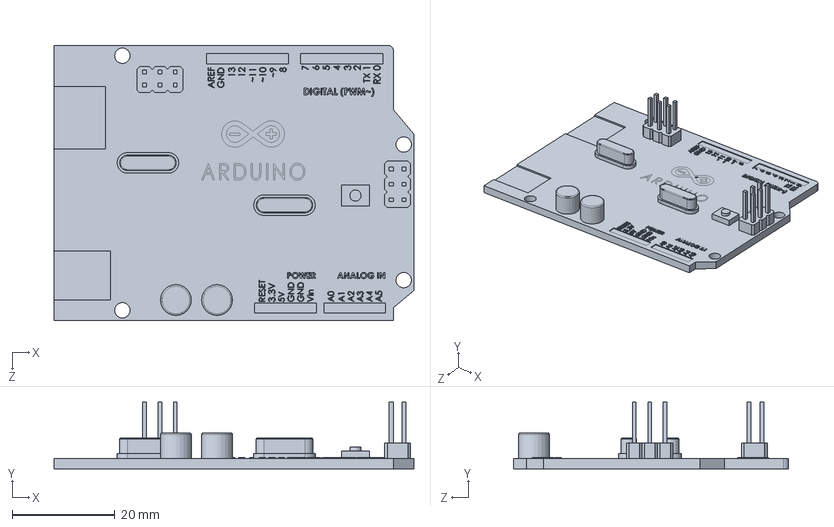
[picture p63: CAD file, 2021-05-26]
Prototype/Parts/Body parts/Arduino R3 UNO/Arduino board.SLDPRT
70.0 x 13.0 x 53.5 mm
