chenshih881001/Life-Frog/Prototype/Parts/Top layer parts/raspberry-pi-camera-3.snapshot.2/OVA5647_IR-Glas.SLDPRT

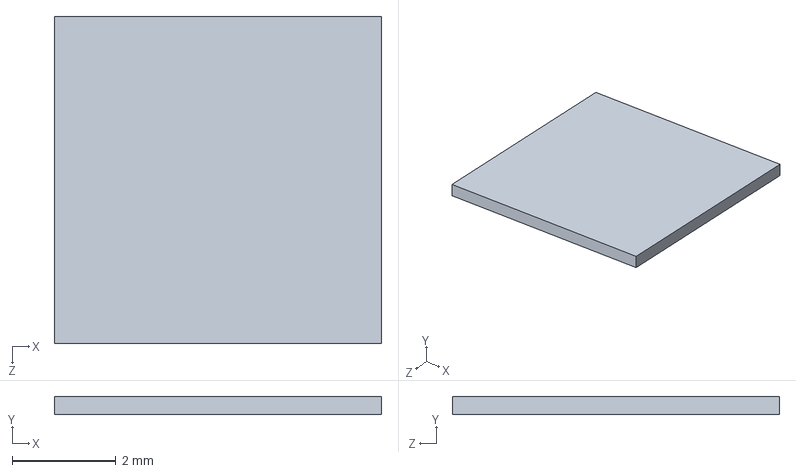
[picture p64: CAD file, 2021-05-28]
Prototype/Parts/Top layer parts/raspberry-pi-camera-3.snapshot.2/OVA5647_IR-Glas.SLDPRT
6.30 x 0.35 x 6.30 mm
