chenshih881001/Life-Frog/Prototype/Parts/Track parts/Roller v.1.2.SLDPRT

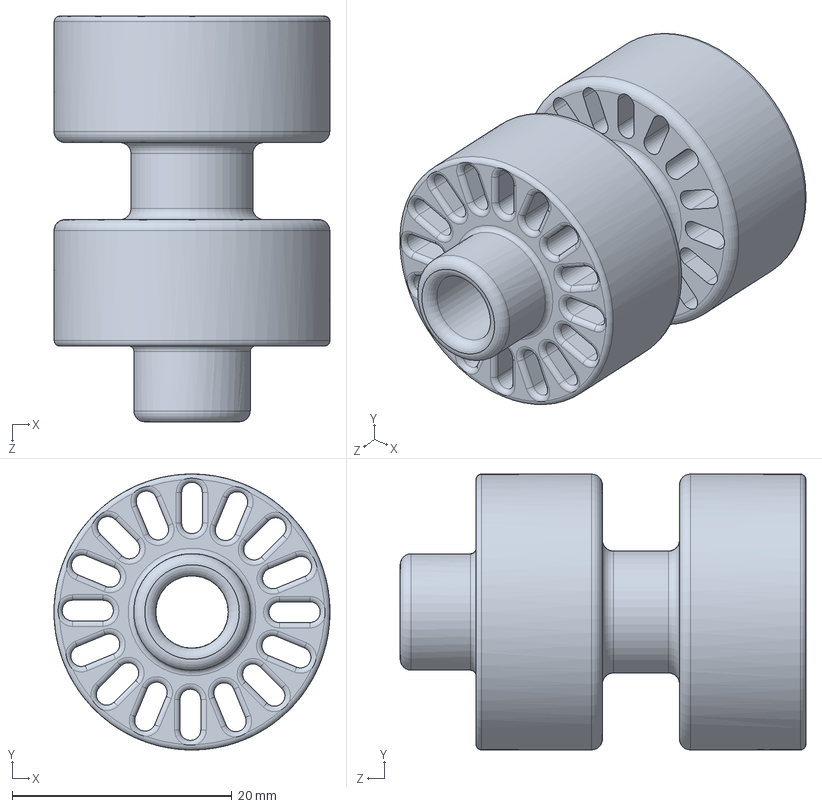
[picture p65: CAD file, 2021-05-28]
Prototype/Parts/Track parts/Roller v.1.2.SLDPRT
25.1 x 25.1 x 36.9 mm
