chenshih881001/Life-Frog/Prototype/To print/1. Drive/4. Idler.STEP

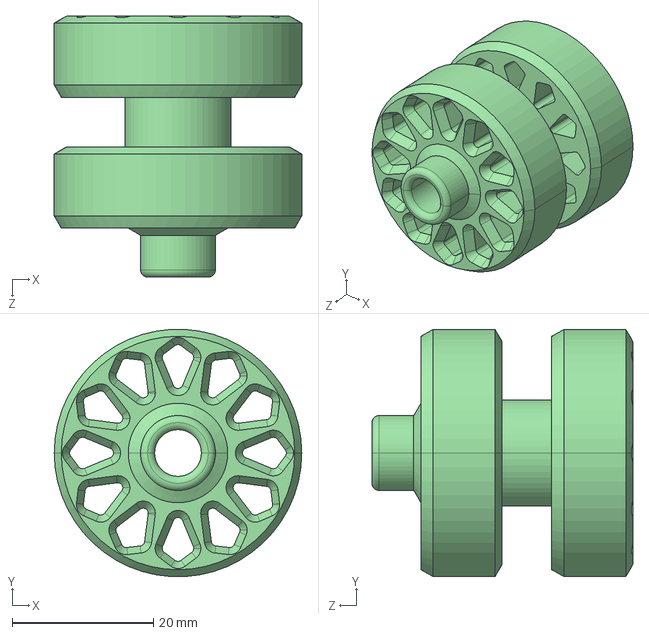
[picture p66: CAD file, 2021-05-28]
Prototype/To print/1. Drive/4. Idler.STEP
35.0 x 34.9 x 36.9 mm
