chenshih881001/Life-Frog/Prototype/To print/2. Body/9. Mounting Platform.STEP

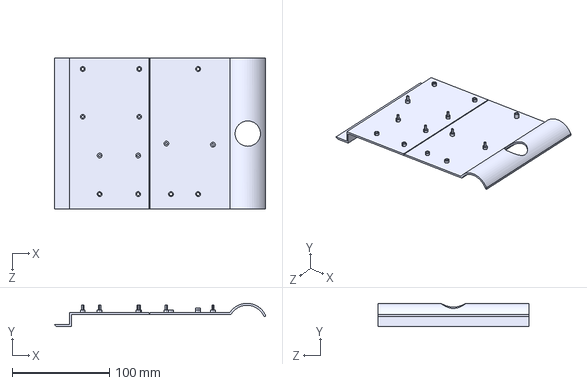
[picture p67: CAD file, 2021-05-27]
Prototype/To print/2. Body/9. Mounting Platform.STEP
216.7 x 23.9 x 155.5 mm
