chenshih881001/Life-Frog/Prototype/To print/3. Upper/12. Compartment door.STEP

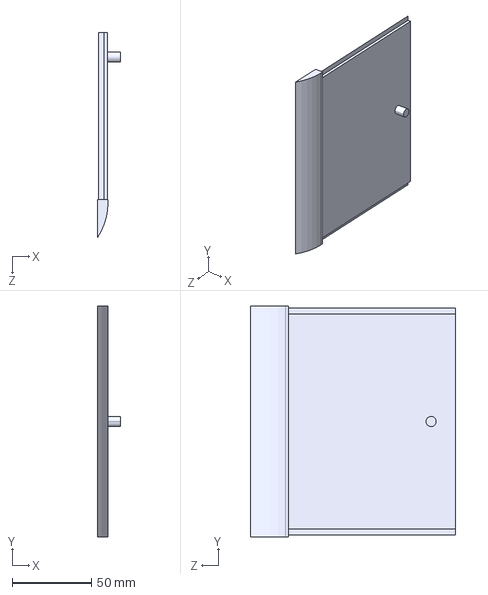
[picture p68: CAD file, 2021-05-27]
Prototype/To print/3. Upper/12. Compartment door.STEP
14.3 x 145.5 x 129.0 mm
