chenshih881001/Life-Frog/Prototype/Parts/Body parts/Box.SLDPRT

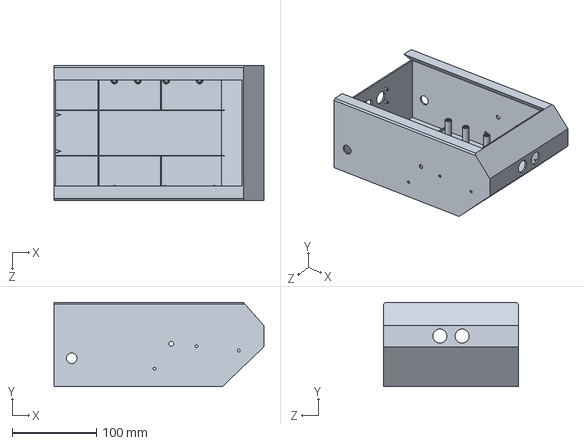
[picture p70: CAD file, 2021-05-27]
Prototype/Parts/Body parts/Box.SLDPRT
249.4 x 100.0 x 160.0 mm
