chenshih881001/Life-Frog/Prototype/Parts/Body parts/Rasp pi/Microphone Plug, RPi4ModelB.SLDPRT

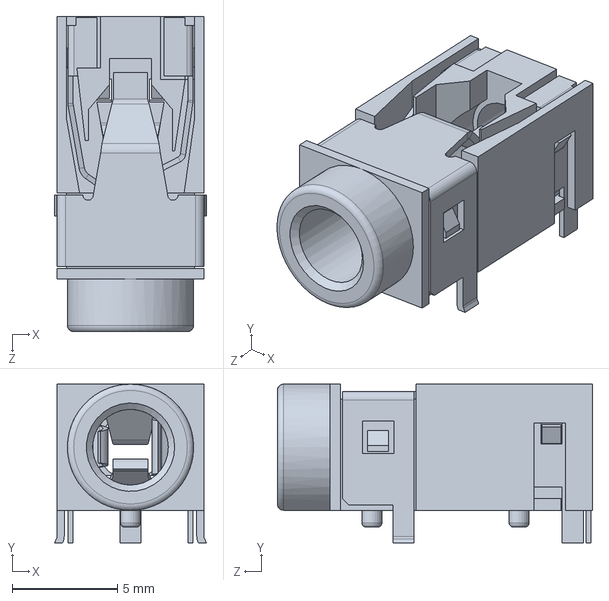
[picture p71: CAD file, 2021-05-26]
Prototype/Parts/Body parts/Rasp pi/Microphone Plug, RPi4ModelB.SLDPRT
7.23 x 7.55 x 15.0 mm
