chenshih881001/Life-Frog/Prototype/Parts/Top layer parts/raspberry-pi-camera-3.snapshot.2/RasPi_Camera_Board.SLDPRT

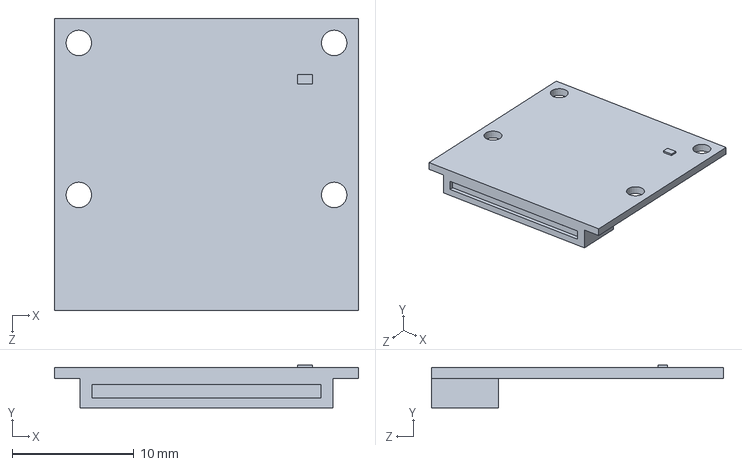
[picture p72: CAD file, 2021-05-28]
Prototype/Parts/Top layer parts/raspberry-pi-camera-3.snapshot.2/RasPi_Camera_Board.SLDPRT
25.0 x 3.50 x 24.0 mm
