chenshih881001/Life-Frog/Prototype/Parts/Track parts/Final Track.SLDPRT

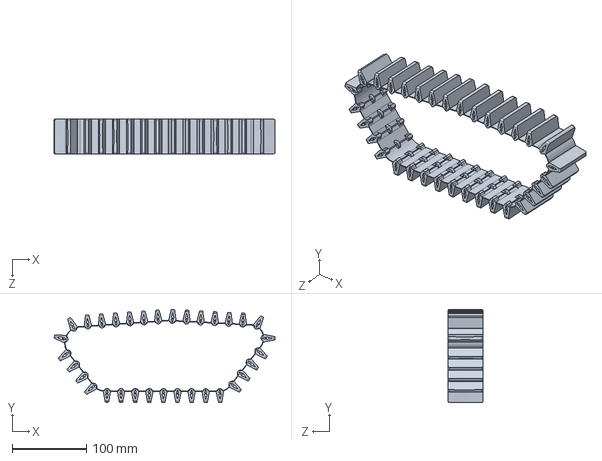
[picture p73: CAD file, 2021-05-28]
Prototype/Parts/Track parts/Final Track.SLDPRT
297.8 x 125.6 x 47.0 mm
