chenshih881001/Life-Frog/Prototype/To print/1. Drive/5. Roller.STEP

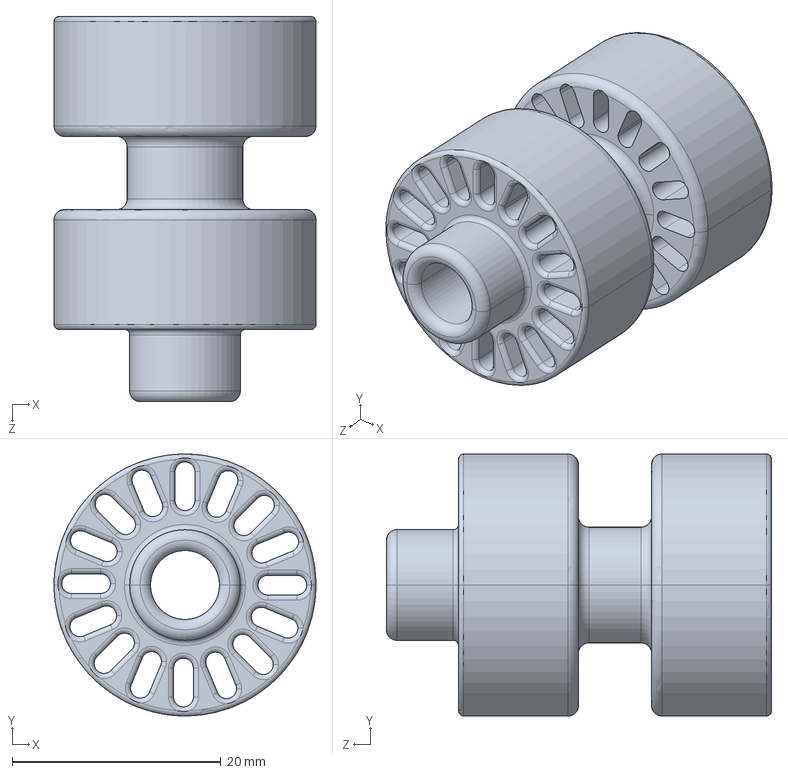
[picture p74: CAD file, 2021-05-28]
Prototype/To print/1. Drive/5. Roller.STEP
25.1 x 25.1 x 36.9 mm
