chenshih881001/Life-Frog/Prototype/To print/3. Upper/10. Hood.STEP

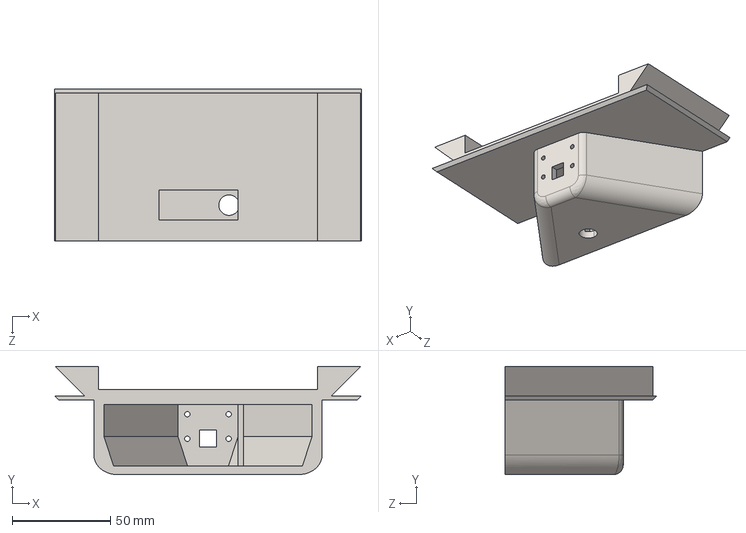
[picture p75: CAD file, 2021-05-27]
Prototype/To print/3. Upper/10. Hood.STEP
156.0 x 55.0 x 77.0 mm
