chenshih881001/Life-Frog/Prototype/Parts/Body parts/Arduino R3 UNO/Jack Socket.SLDPRT

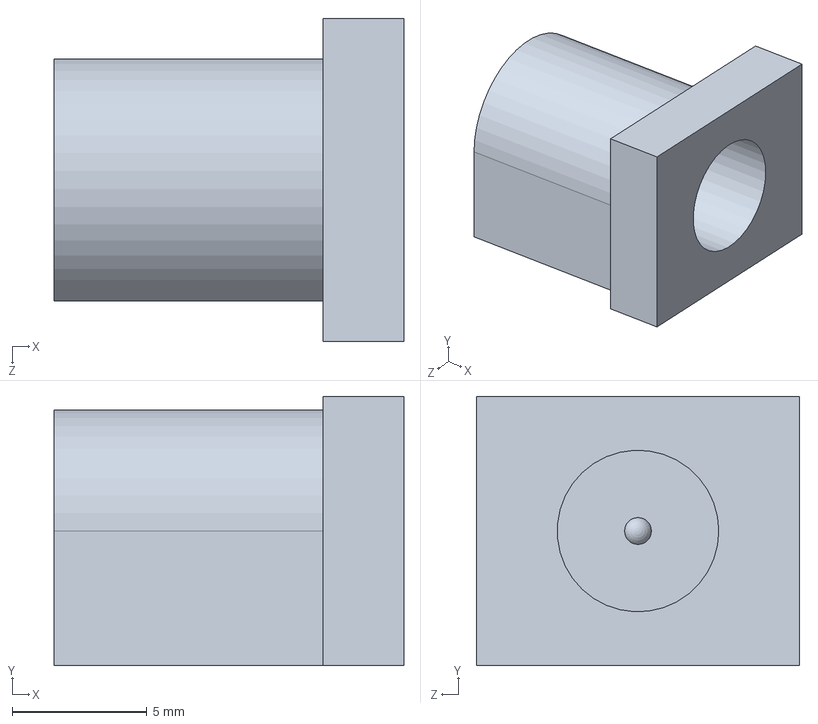
[picture p76: CAD file, 2021-05-26]
Prototype/Parts/Body parts/Arduino R3 UNO/Jack Socket.SLDPRT
13.0 x 10.0 x 12.0 mm
