chenshih881001/Life-Frog/Prototype/Parts/Body parts/Layer-2_Mounting.SLDPRT

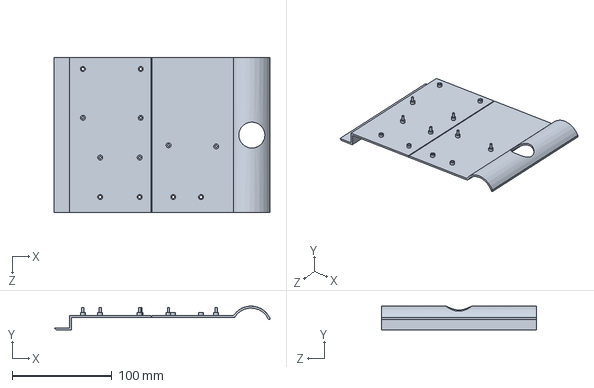
[picture p77: CAD file, 2021-05-27]
Prototype/Parts/Body parts/Layer-2_Mounting.SLDPRT
216.7 x 23.9 x 155.5 mm
