chenshih881001/Life-Frog/Prototype/Parts/Track parts/Axle Bearing.SLDPRT

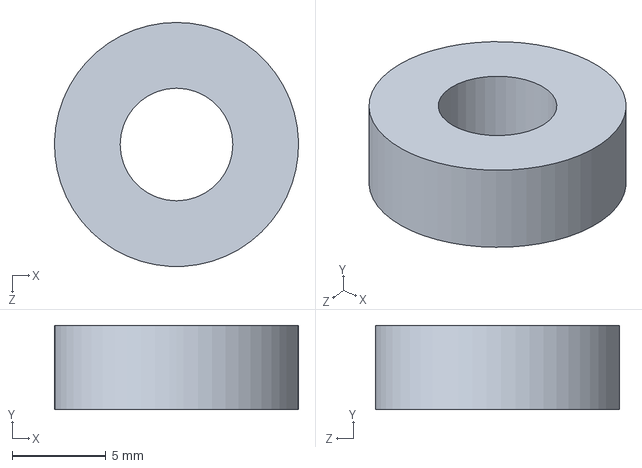
[picture p78: CAD file, 2021-05-28]
Prototype/Parts/Track parts/Axle Bearing.SLDPRT
13.0 x 4.50 x 13.0 mm
