chenshih881001/Life-Frog/Prototype/To print/1. Drive/7. Sprocket Cap.STEP

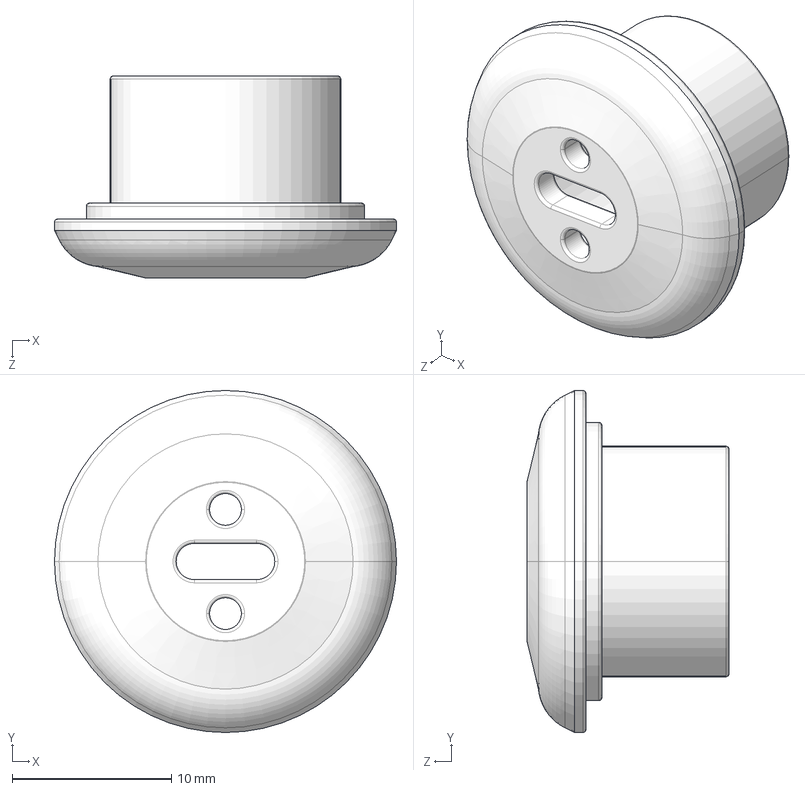
[picture p79: CAD file, 2021-05-27]
Prototype/To print/1. Drive/7. Sprocket Cap.STEP
21.5 x 21.5 x 12.7 mm
