chenshih881001/Life-Frog/Prototype/To print/3. Upper/11. Compartment.STEP

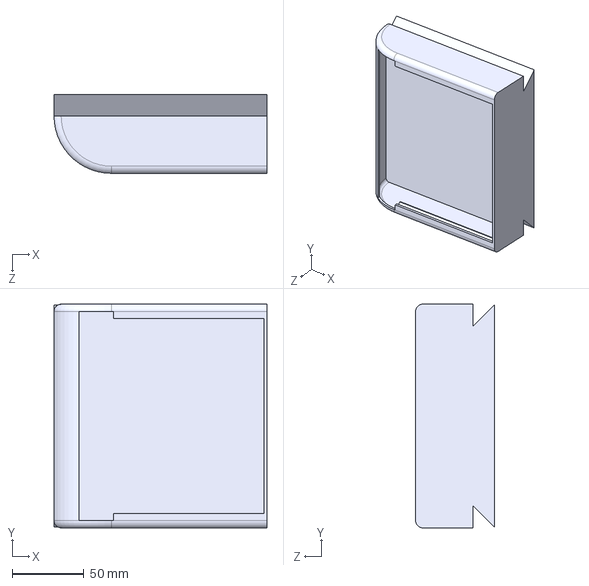
[picture p80: CAD file, 2021-05-27]
Prototype/To print/3. Upper/11. Compartment.STEP
148.5 x 156.0 x 54.9 mm
