chenshih881001/Life-Frog/Prototype/Parts/Body parts/Arduino R3 UNO/IC socket.SLDPRT

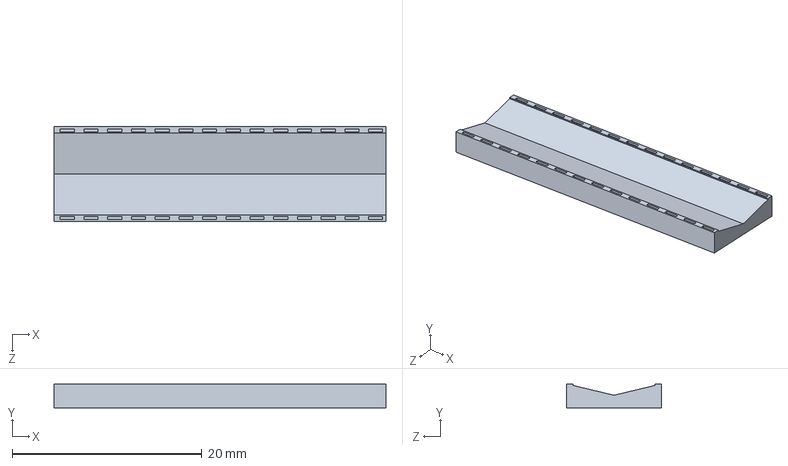
[picture p81: CAD file, 2021-05-26]
Prototype/Parts/Body parts/Arduino R3 UNO/IC socket.SLDPRT
35.0 x 2.50 x 10.0 mm
