chenshih881001/Life-Frog/Prototype/Parts/Body parts/ultrasonic-sensor.STEP

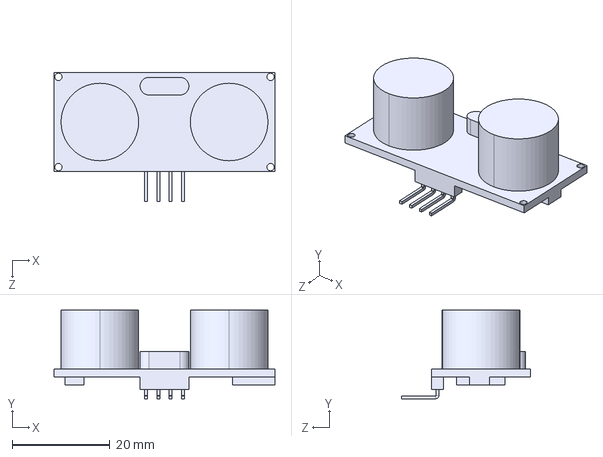
[picture p82: CAD file, 2021-05-26]
Prototype/Parts/Body parts/ultrasonic-sensor.STEP
45.3 x 18.2 x 26.4 mm
