chenshih881001/Life-Frog/Prototype/Parts/Top layer parts/raspberry-pi-camera-3.snapshot.2/OVA5647_Housing.SLDPRT

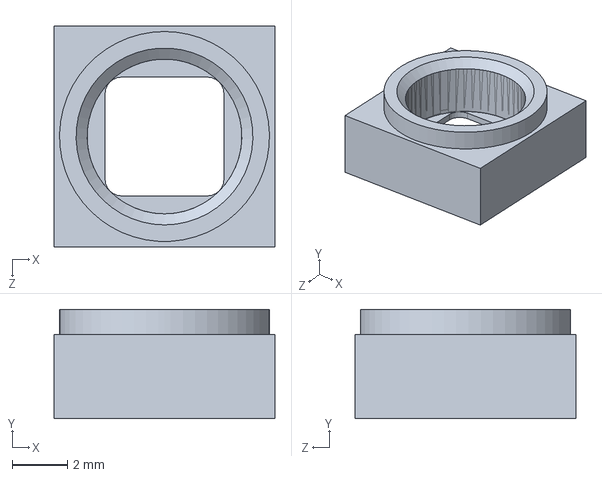
[picture p83: CAD file, 2021-05-28]
Prototype/Parts/Top layer parts/raspberry-pi-camera-3.snapshot.2/OVA5647_Housing.SLDPRT
8.00 x 3.95 x 8.00 mm
