chenshih881001/Life-Frog/Prototype/To print/1. Drive/2. Holder Left.STEP

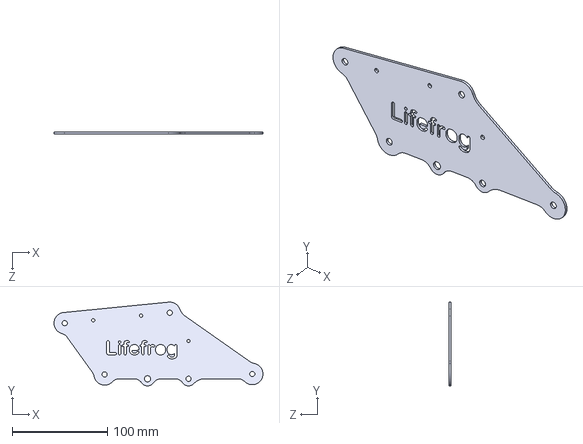
[picture p84: CAD file, 2021-05-27]
Prototype/To print/1. Drive/2. Holder Left.STEP
219.2 x 87.9 x 2.00 mm
