chenshih881001/Life-Frog/Prototype/Parts/Body parts/motorcontroler.STEP

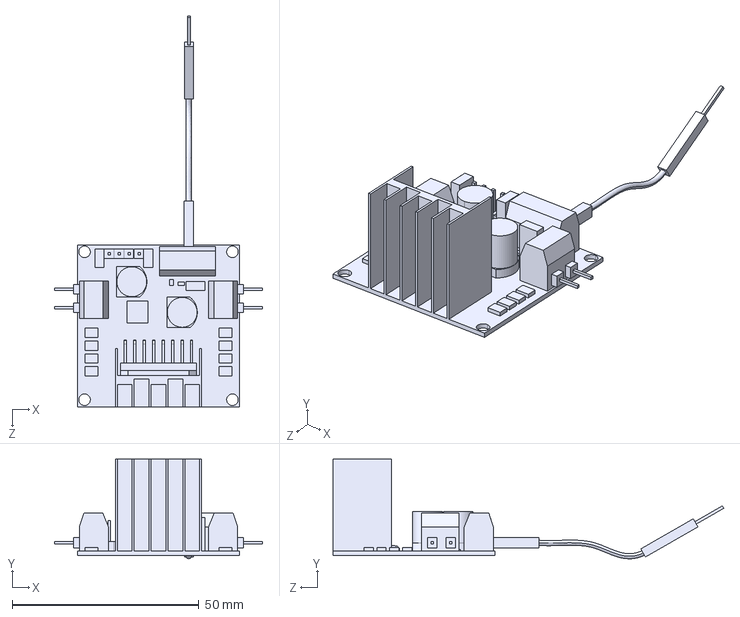
[picture p85: CAD file, 2021-05-26]
Prototype/Parts/Body parts/motorcontroler.STEP
55.7 x 26.7 x 104.6 mm
