chenshih881001/Life-Frog/Prototype/Parts/Top layer parts/raspberry-pi-camera-3.snapshot.2/OVA5647_Pigtail.SLDPRT

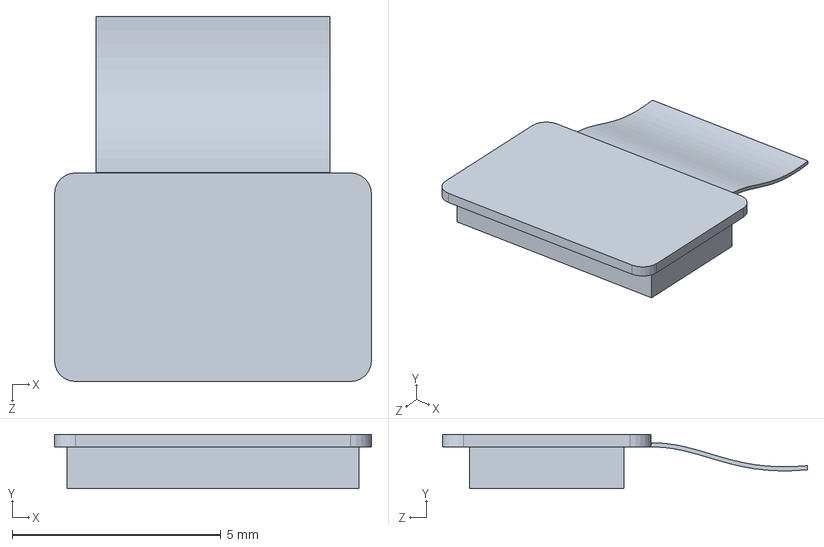
[picture p86: CAD file, 2021-05-28]
Prototype/Parts/Top layer parts/raspberry-pi-camera-3.snapshot.2/OVA5647_Pigtail.SLDPRT
7.60 x 1.30 x 8.75 mm
