chenshih881001/Life-Frog/Prototype/To print/1. Drive/6. Sprocket.STEP

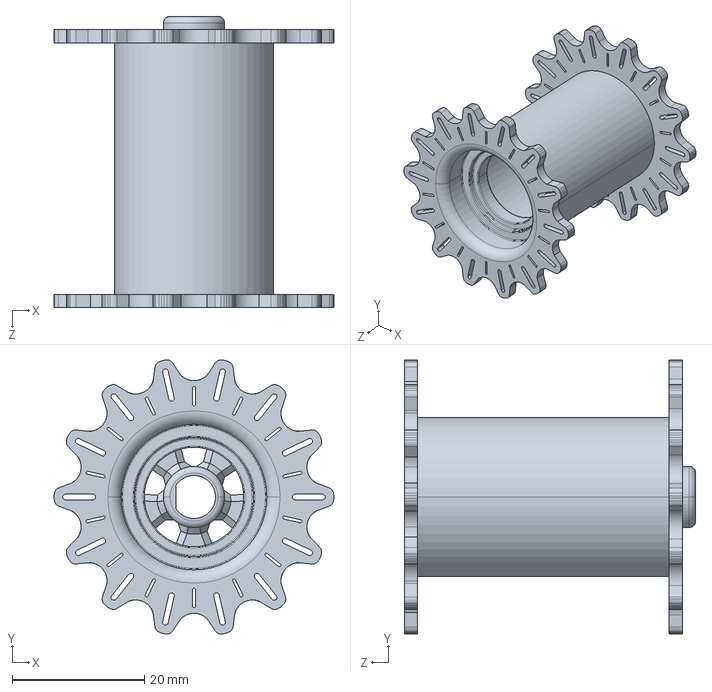
[picture p87: CAD file, 2021-05-27]
Prototype/To print/1. Drive/6. Sprocket.STEP
42.3 x 41.3 x 44.0 mm
