chenshih881001/Life-Frog/Prototype/Parts/Body parts/Arduino R3 UNO/IC body.SLDPRT

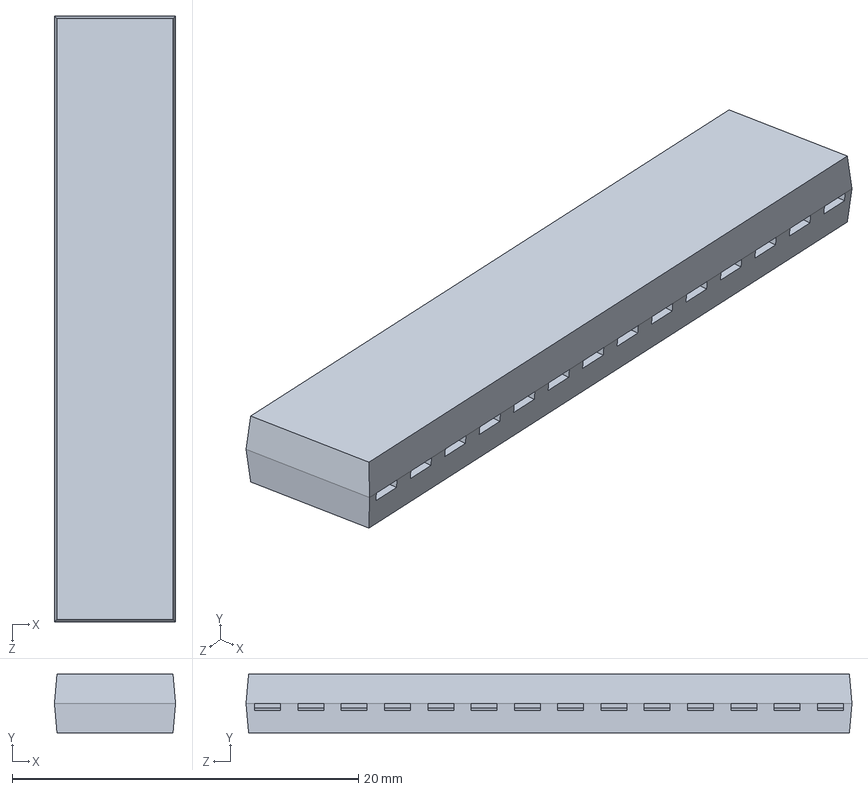
[picture p88: CAD file, 2021-05-26]
Prototype/Parts/Body parts/Arduino R3 UNO/IC body.SLDPRT
7.00 x 3.40 x 35.0 mm
