chenshih881001/Life-Frog/Prototype/Parts/Body parts/Rasp pi/Female Micro HDMI Connector, RPi4ModelB.SLDPRT

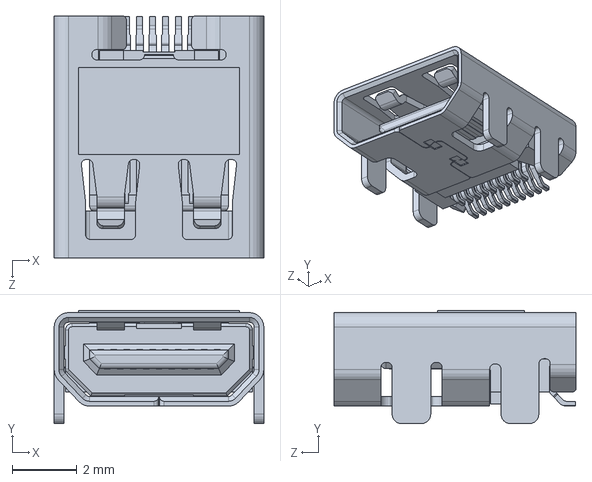
[picture p89: CAD file, 2021-05-26]
Prototype/Parts/Body parts/Rasp pi/Female Micro HDMI Connector, RPi4ModelB.SLDPRT
6.50 x 3.52 x 7.50 mm
