chenshih881001/Life-Frog/Prototype/Parts/Body parts/raspery-pi-pi-cam.STEP

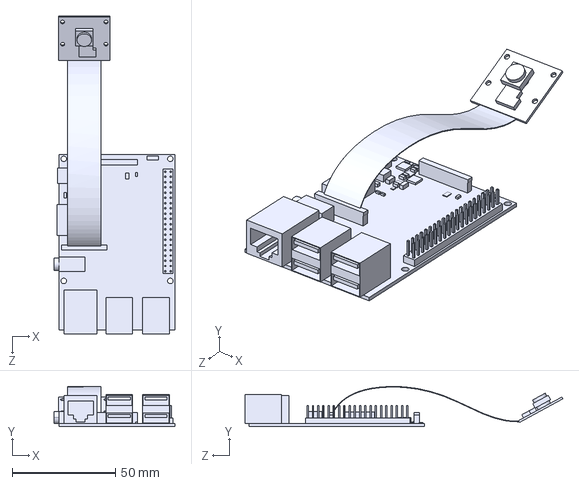
[picture p90: CAD file, 2021-05-26]
Prototype/Parts/Body parts/raspery-pi-pi-cam.STEP
58.4 x 19.4 x 154.0 mm
