chenshih881001/Life-Frog/Prototype/Parts/Top layer parts/Hood.SLDPRT

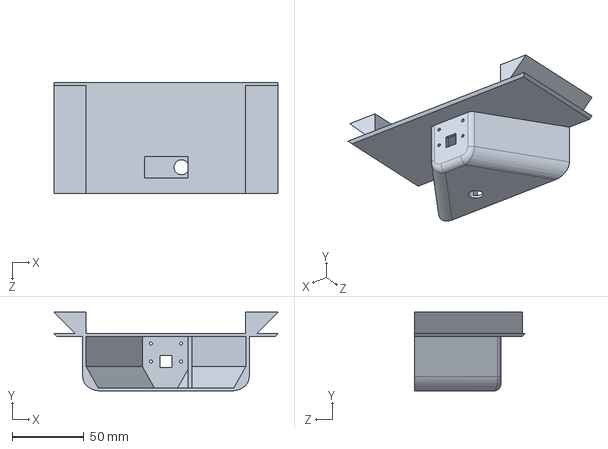
[picture p91: CAD file, 2021-05-26]
Prototype/Parts/Top layer parts/Hood.SLDPRT
156.0 x 55.0 x 77.0 mm
