chenshih881001/Life-Frog/Prototype/Parts/Top layer parts/raspberry-pi-camera-3.snapshot.2/OVA5647_Lens.SLDPRT

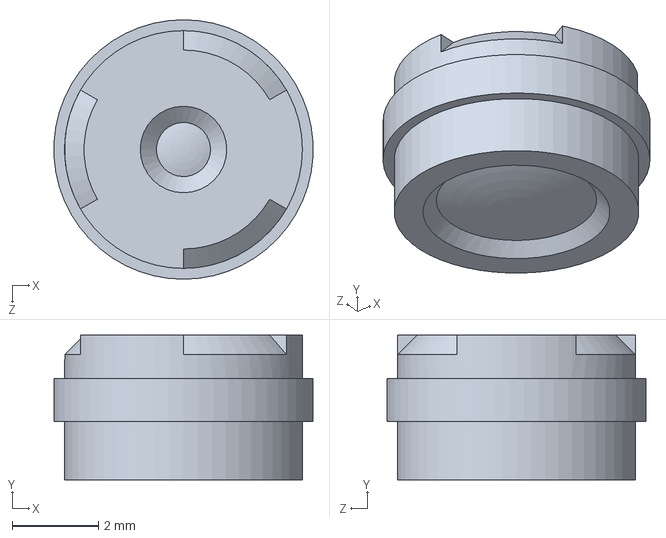
[picture p92: CAD file, 2021-05-28]
Prototype/Parts/Top layer parts/raspberry-pi-camera-3.snapshot.2/OVA5647_Lens.SLDPRT
5.99 x 3.35 x 6.00 mm
