chenshih881001/Life-Frog/Prototype/Parts/Body parts/Arduino R3 UNO/IC pin.SLDPRT

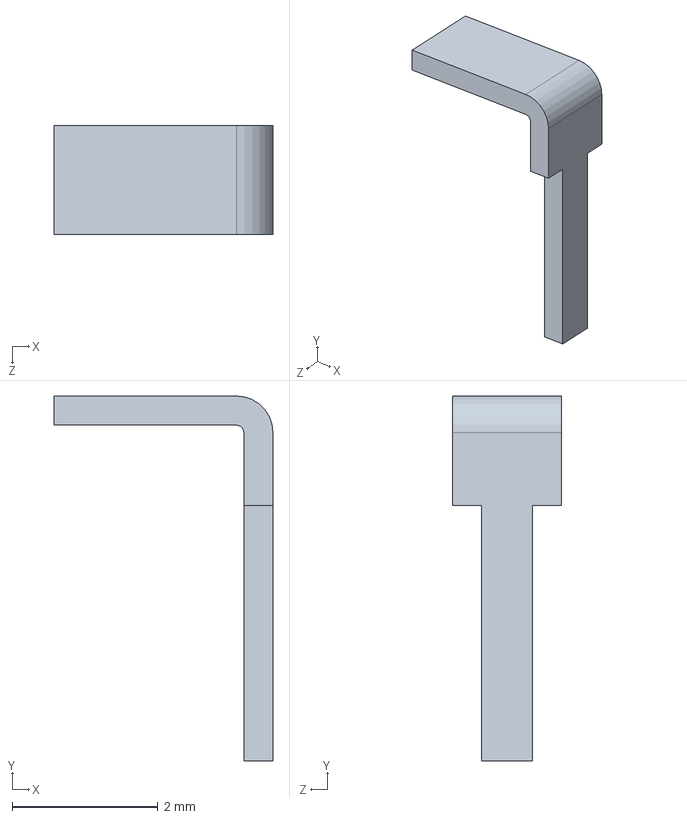
[picture p93: CAD file, 2021-05-26]
Prototype/Parts/Body parts/Arduino R3 UNO/IC pin.SLDPRT
3.00 x 5.00 x 1.50 mm
