chenshih881001/Life-Frog/Prototype/Parts/Body parts/arduino-UNO.STEP

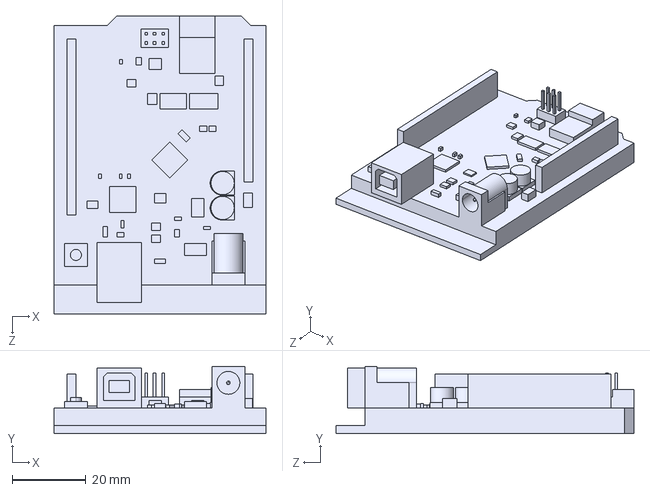
[picture p94: CAD file, 2021-05-26]
Prototype/Parts/Body parts/arduino-UNO.STEP
57.5 x 18.3 x 80.7 mm
