chenshih881001/Life-Frog/Prototype/Parts/Body parts/Rasp pi/2.54 mm DUPONT MALE PIN HEADER, POE, 2X2, RPi4ModelB.SLDPRT

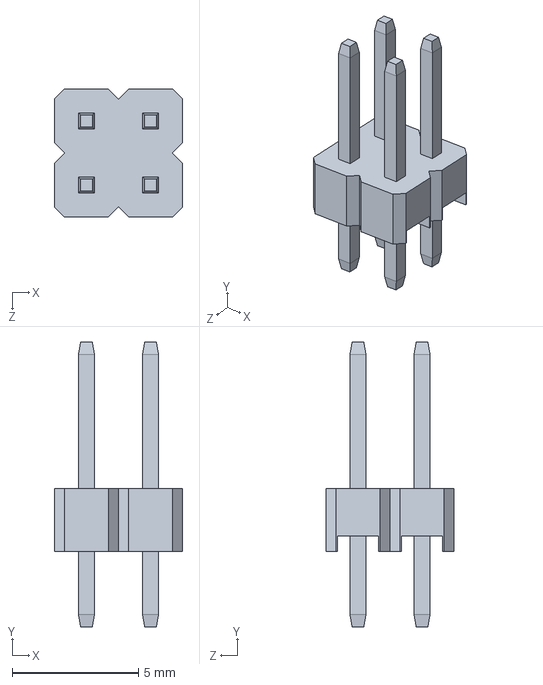
[picture p95: CAD file, 2021-05-26]
Prototype/Parts/Body parts/Rasp pi/2.54 mm DUPONT MALE PIN HEADER, POE, 2X2, RPi4ModelB.SLDPRT
5.08 x 11.3 x 5.08 mm
