chenshih881001/Life-Frog/Prototype/Parts/Top layer parts/raspberry-pi-camera-3.snapshot.2/RasPi_Camera.STEP

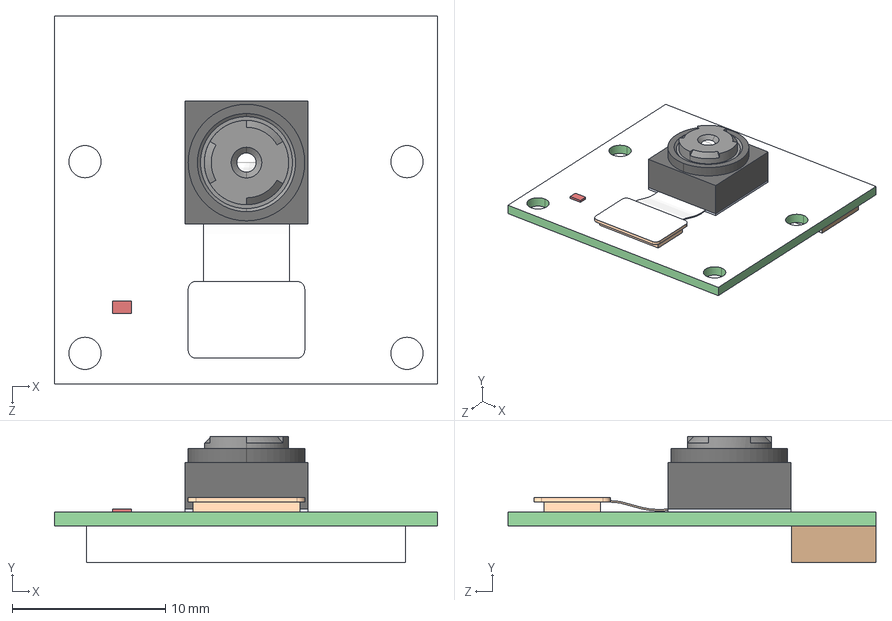
[picture p96: CAD file, 2021-05-28]
Prototype/Parts/Top layer parts/raspberry-pi-camera-3.snapshot.2/RasPi_Camera.STEP
25.0 x 8.25 x 24.0 mm
RasPi_Camera_Board_Standard
OVA5647_Standard
OVA5647_Housing_Standard
OVA5647_IR-Glas_Standard
OVA5647_Lens_FOV
OVA5647_Pigtail_Standard
