chenshih881001/Life-Frog/Prototype/Parts/Body parts/motor.step.SLDPRT

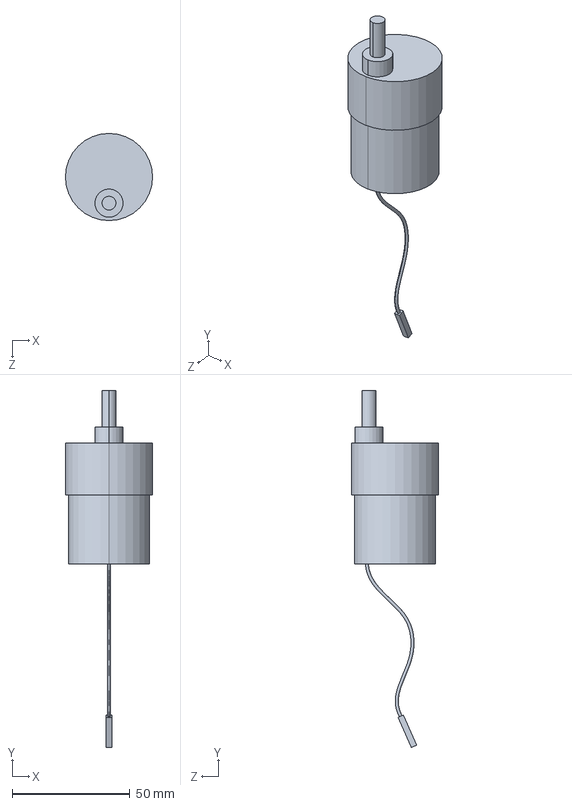
[picture p97: CAD file, 2021-05-23]
Prototype/Parts/Body parts/motor.step.SLDPRT
37.1 x 151.8 x 37.1 mm
