chenshih881001/Life-Frog/Prototype/Parts/Top layer parts/Mic.step.SLDPRT

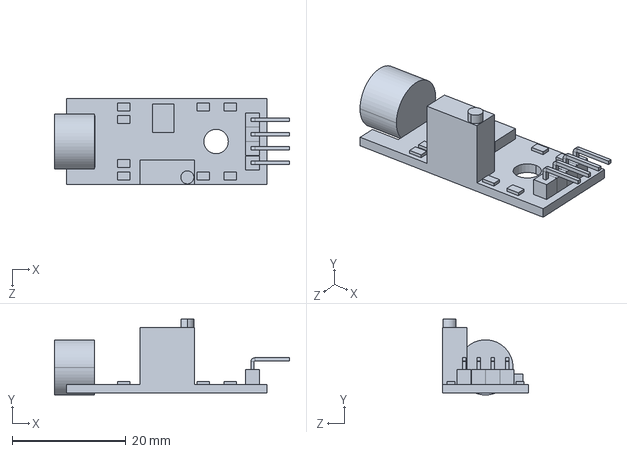
[picture p98: CAD file, 2021-05-26]
Prototype/Parts/Top layer parts/Mic.step.SLDPRT
41.3 x 13.3 x 15.1 mm
