chenshih881001/Life-Frog/Prototype/Parts/Body parts/Arduino R3 UNO/USB socket.SLDPRT

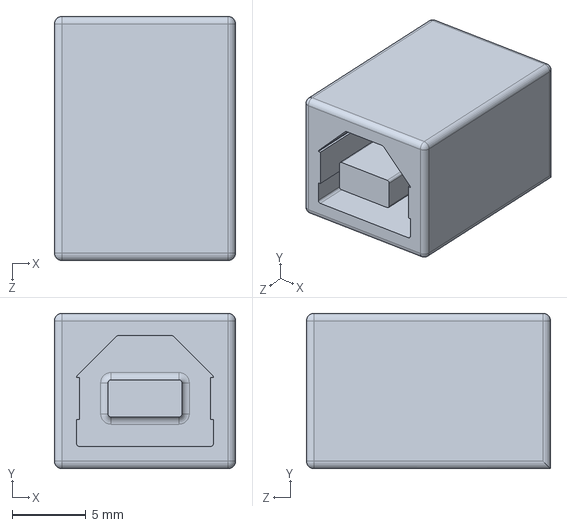
[picture p99: CAD file, 2021-05-26]
Prototype/Parts/Body parts/Arduino R3 UNO/USB socket.SLDPRT
12.2 x 10.5 x 16.5 mm
