chenshih881001/Life-Frog/Prototype/Parts/Body parts/Battery.SLDPRT

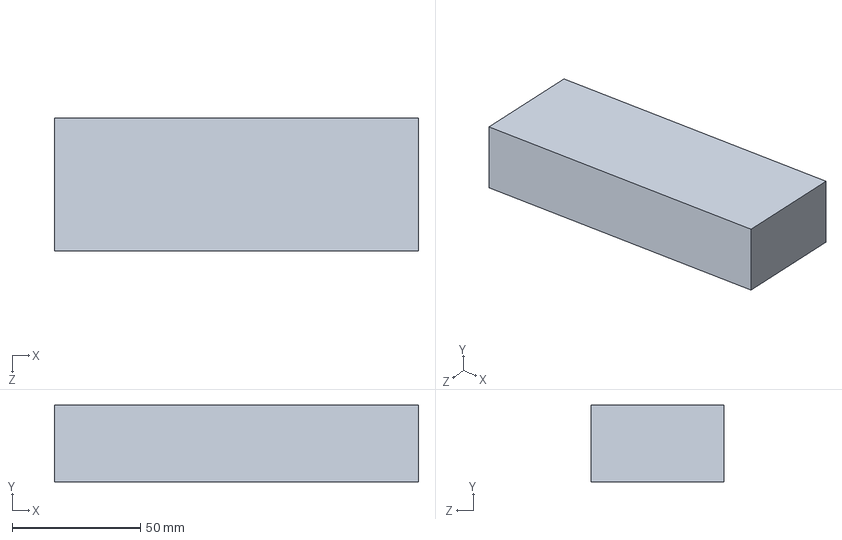
[picture p100: CAD file, 2021-05-23]
Prototype/Parts/Body parts/Battery.SLDPRT
142.0 x 30.0 x 52.0 mm
