chenshih881001/Life-Frog/Prototype/Parts/Body parts/Arduino R3 UNO/pin.SLDPRT

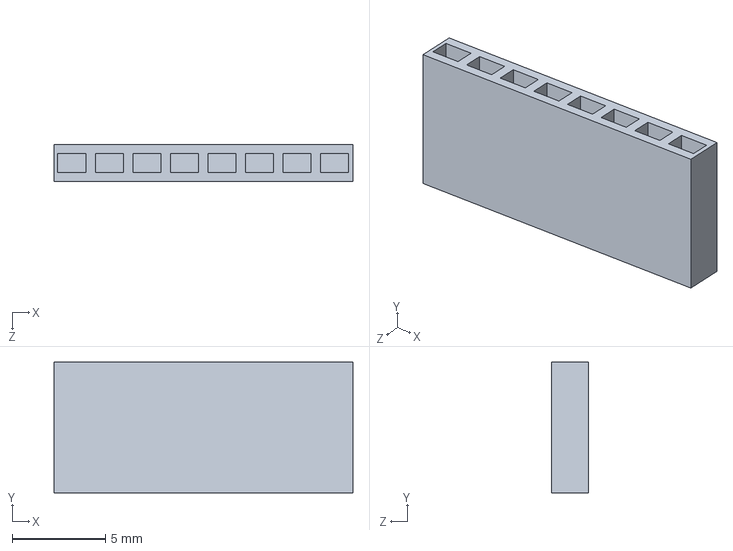
[picture p101: CAD file, 2021-05-26]
Prototype/Parts/Body parts/Arduino R3 UNO/pin.SLDPRT
16.0 x 7.00 x 2.00 mm
