chenshih881001/Life-Frog/Prototype/Parts/Top layer parts/RspCamera.stp

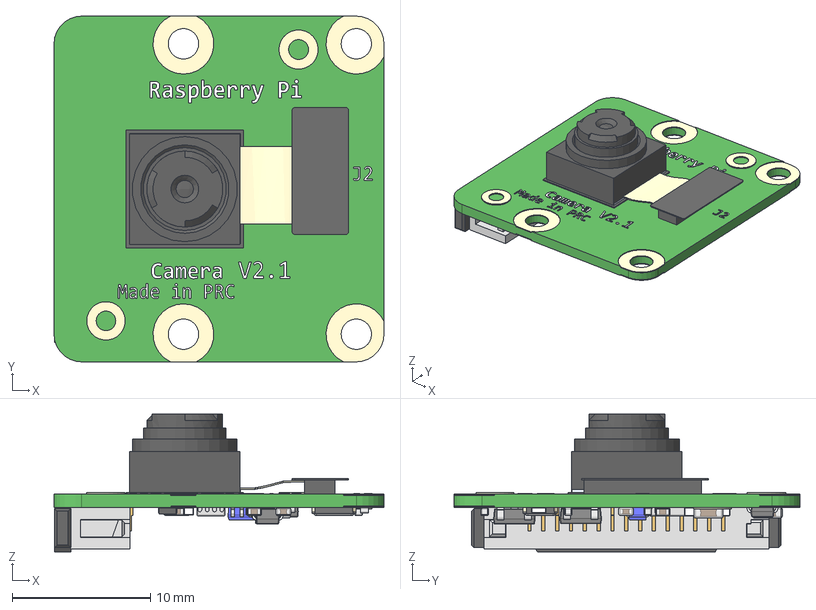
[picture p102: CAD file, 2021-05-25]
Prototype/Parts/Top layer parts/RspCamera.stp
23.9 x 25.0 x 9.96 mm
PicameraPCB
OVA5647_Housing
OVA5647_Lens_FOV
ribbon_cam
CCD
CAPC-0805-T0.75-BN x 2
CAPC-0402-T0.55-BN x 10
RESC-0402 x 3
RESC-0603 x 2
RESC-1210
c-1-1734248-5-e-raspberry_display
SOT23-5 x 3
KX7 SMD Quartz Crystal Resonator 3.2x2.5mm
c6aaa
4pin_smd x 3
