chenshih881001/Life-Frog/Prototype/Parts/Track parts/A Belt.SLDPRT

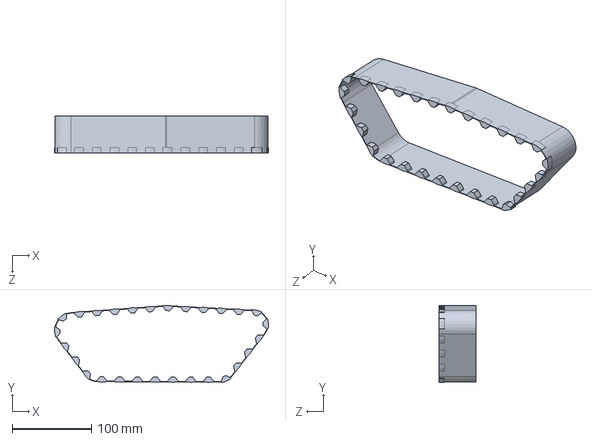
[picture p103: CAD file, 2021-05-24]
Prototype/Parts/Track parts/A Belt.SLDPRT
269.4 x 97.5 x 47.0 mm
