chenshih881001/Life-Frog/Prototype/Parts/Body parts/Rasp pi/VIA VL805 PCIe USB 3.0 controller, RPi4ModelB.SLDPRT

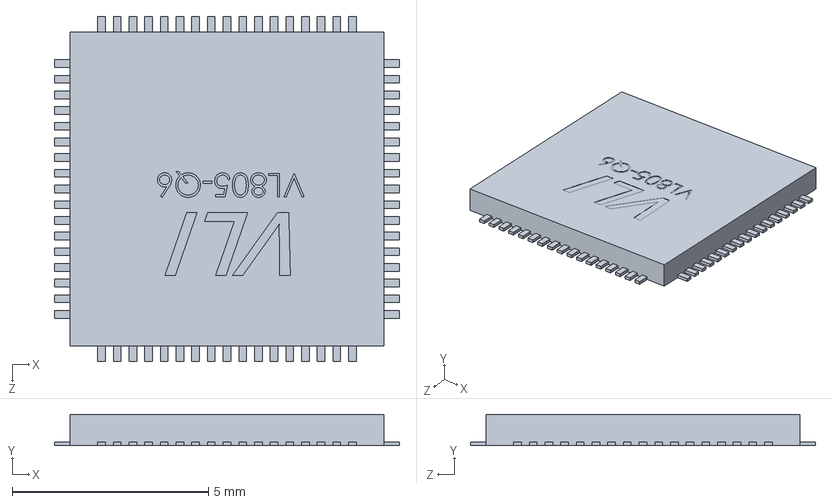
[picture p104: CAD file, 2021-05-26]
Prototype/Parts/Body parts/Rasp pi/VIA VL805 PCIe USB 3.0 controller, RPi4ModelB.SLDPRT
8.80 x 0.8 x 8.80 mm
