chenshih881001/Life-Frog/Prototype/Parts/Body parts/Rasp pi/Female USB Type C Connector, RPi4ModelB.SLDPRT

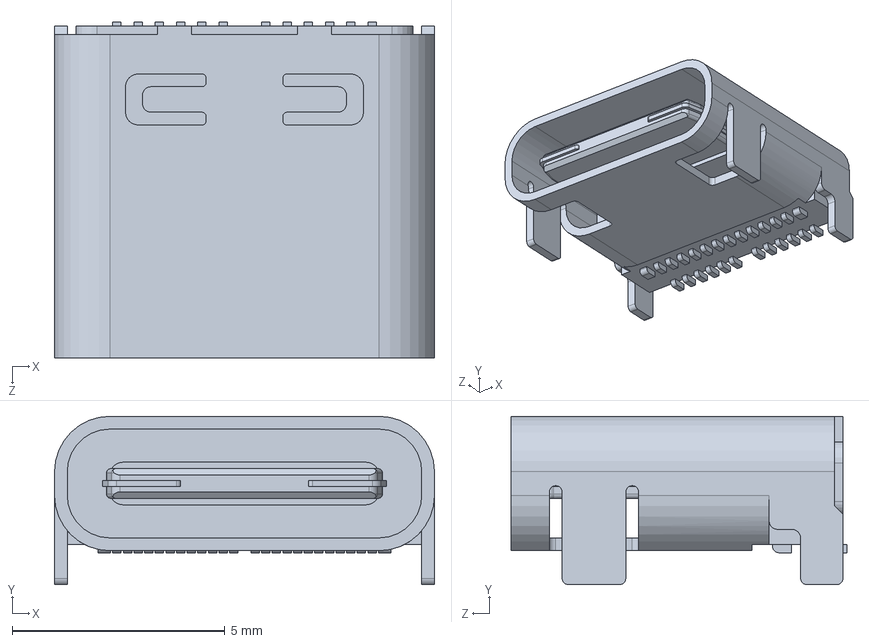
[picture p105: CAD file, 2021-05-26]
Prototype/Parts/Body parts/Rasp pi/Female USB Type C Connector, RPi4ModelB.SLDPRT
8.94 x 3.96 x 7.90 mm
