chenshih881001/Life-Frog/Prototype/Parts/Track parts/Sprocket2 - Copy.SLDPRT

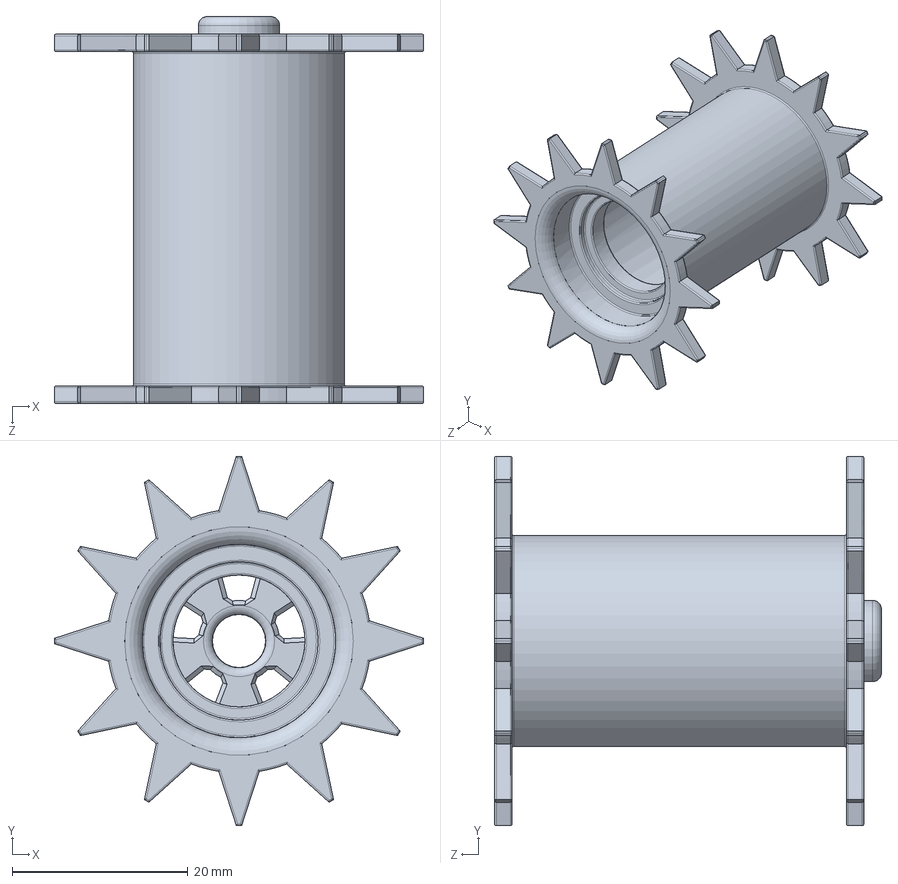
[picture p106: CAD file, 2021-05-23]
Prototype/Parts/Track parts/Sprocket2 - Copy.SLDPRT
42.0 x 42.0 x 44.0 mm
