chenshih881001/Life-Frog/Prototype/Parts/Body parts/Rasp pi/2X USB3.0 PORTS, RPi4ModelB.SLDPRT

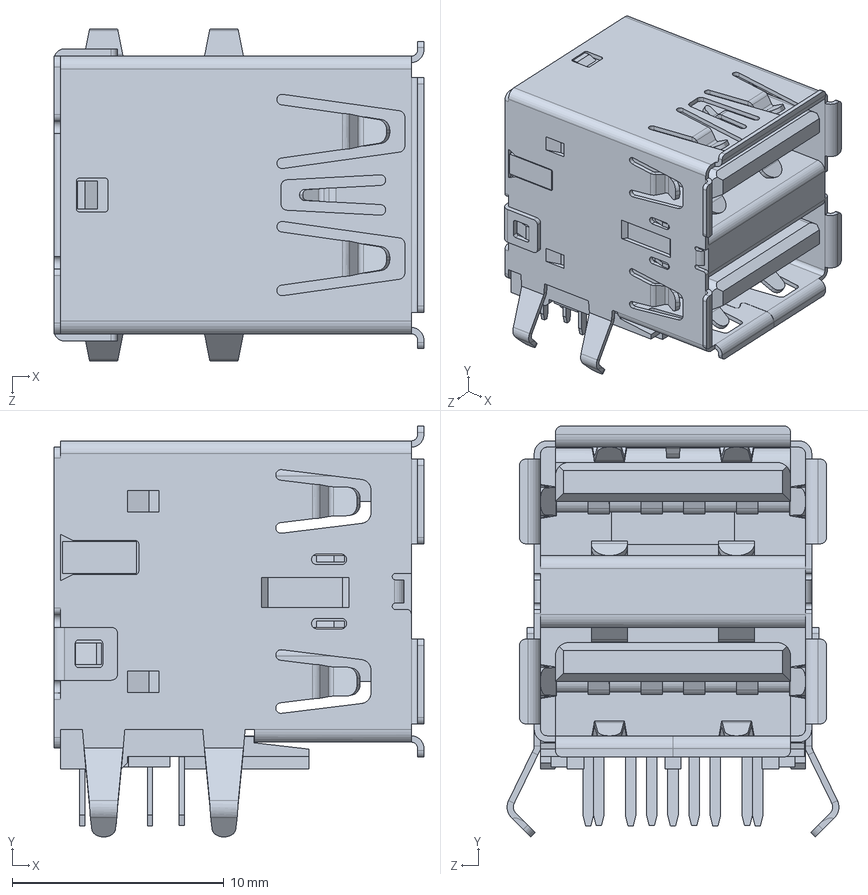
[picture p107: CAD file, 2021-05-26]
Prototype/Parts/Body parts/Rasp pi/2X USB3.0 PORTS, RPi4ModelB.SLDPRT
17.5 x 19.4 x 15.7 mm
