chenshih881001/Life-Frog/Prototype/Parts/Track parts/Holder.SLDPRT

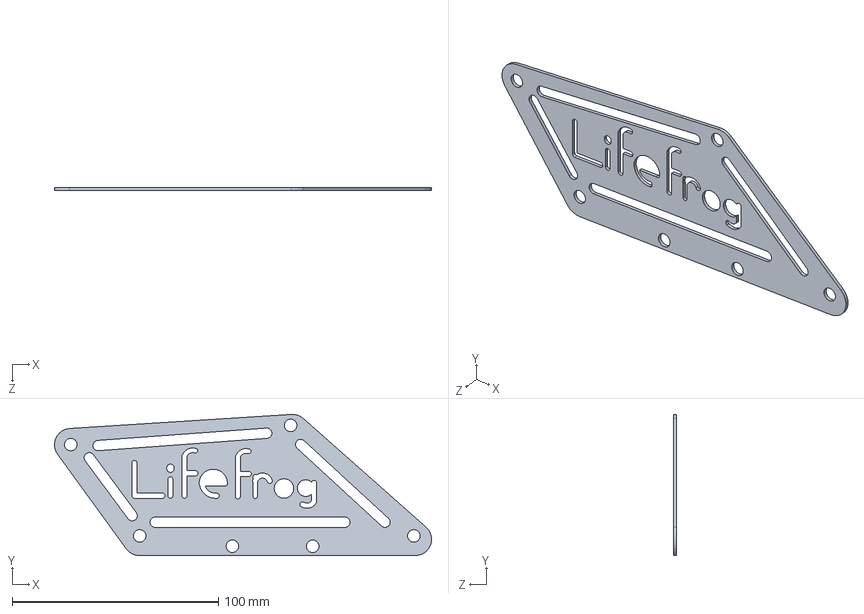
[picture p108: CAD file, 2021-05-21]
Prototype/Parts/Track parts/Holder.SLDPRT
182.9 x 68.5 x 1.50 mm
