chenshih881001/Life-Frog/Prototype/Parts/Body parts/Rasp pi/Broadcom BCM54213PE Gigabit Ethernet Transceiver, RPi4ModelB.SLDPRT

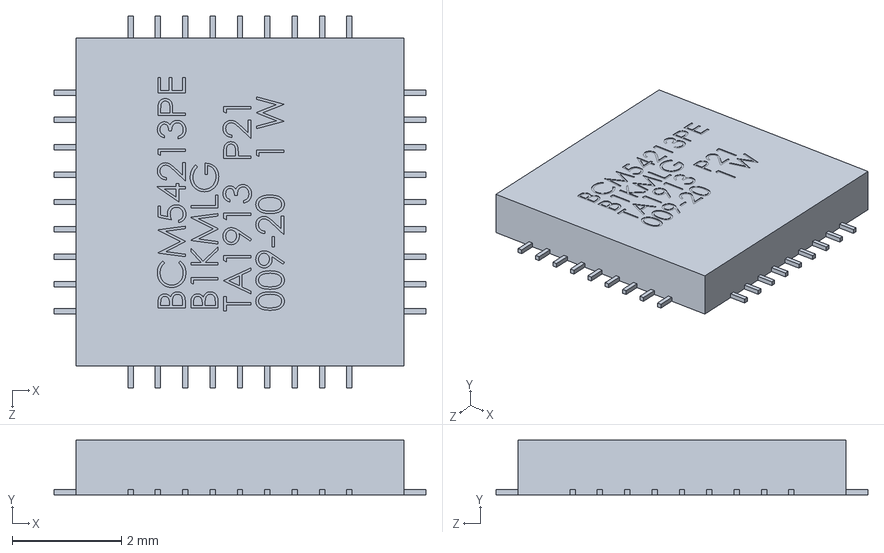
[picture p109: CAD file, 2021-05-26]
Prototype/Parts/Body parts/Rasp pi/Broadcom BCM54213PE Gigabit Ethernet Transceiver, RPi4ModelB.SLDPRT
6.80 x 1.00 x 6.80 mm
