chenshih881001/Life-Frog/Prototype/Parts/Body parts/Rasp pi/2X USB2.0 PORTS, RPi4ModelB.SLDPRT

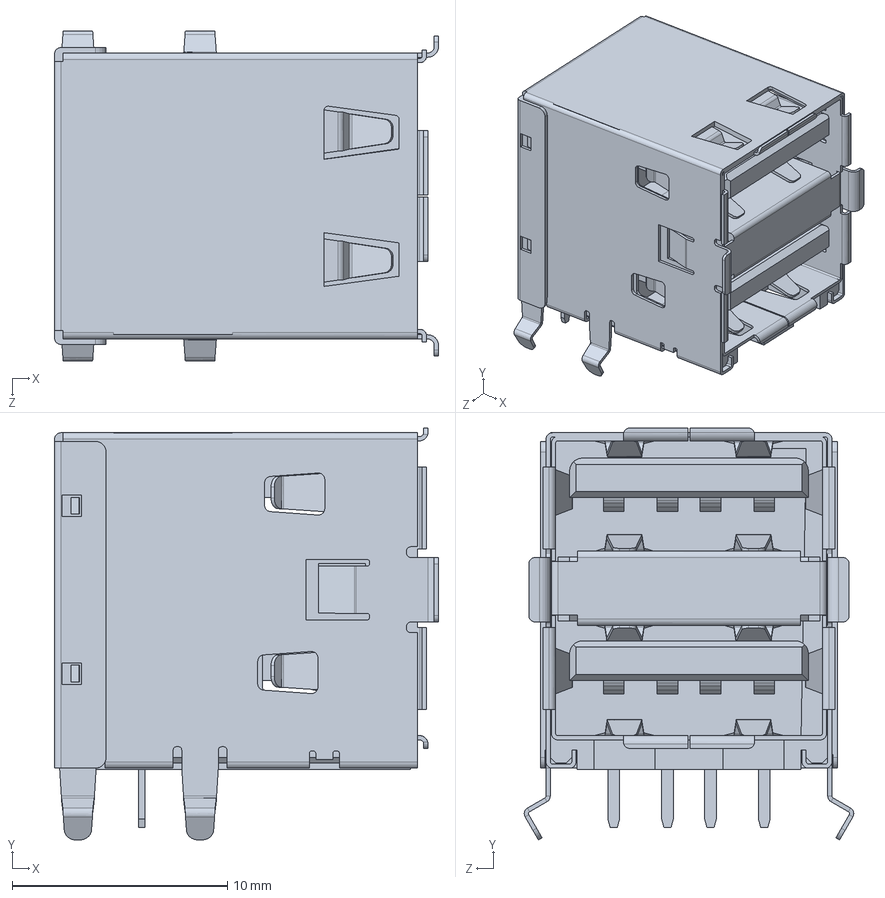
[picture p110: CAD file, 2021-05-26]
Prototype/Parts/Body parts/Rasp pi/2X USB2.0 PORTS, RPi4ModelB.SLDPRT
17.9 x 19.2 x 15.3 mm
