chenshih881001/Life-Frog/Prototype/Parts/Body parts/Rasp pi/Cypress CYW43455 Wireless Module Cover, RPi4ModelB.SLDPRT

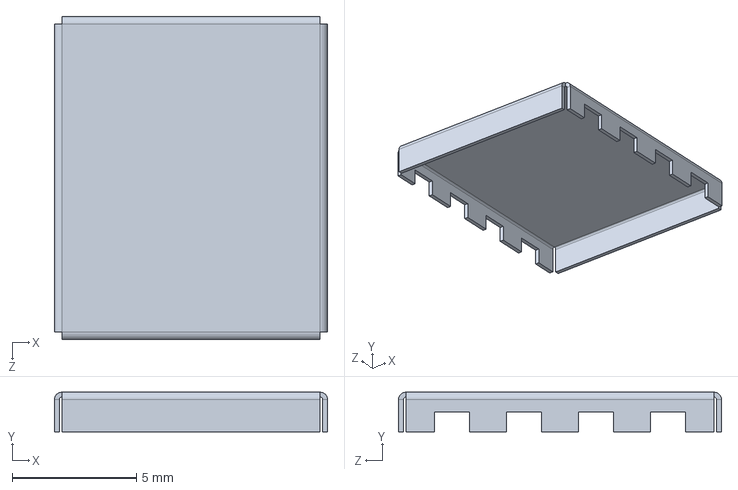
[picture p111: CAD file, 2021-05-26]
Prototype/Parts/Body parts/Rasp pi/Cypress CYW43455 Wireless Module Cover, RPi4ModelB.SLDPRT
11.0 x 1.60 x 13.0 mm
