chenshih881001/Life-Frog/(list of files, cad)

Other CAD files:
Prototype/Parts/Top layer parts/RspCamera.stp.SLDASM
Prototype/To print/2. Body/8. Hull.STEP
Prototype/Parts/Top layer parts/Compartment.SLDPRT
Prototype/Parts/Track parts/Idler v.1.2.SLDPRT
Prototype/Parts/Top layer parts/Hood with Tolerence.SLDPRT
Prototype/Parts/Track parts/Holder final.SLDPRT
Prototype/Parts/Track parts/Holder final Opposite.SLDPRT
Prototype/To print/1. Drive/3. Holder Right.STEP
Prototype/Parts/Top layer parts/compartment door.SLDPRT
Prototype/Parts/Track parts/Sprocket Final.SLDPRT
Prototype/Parts/Track parts/Sprocket Cap.SLDPRT
Prototype/Parts/Top layer parts/Compartment - No Tolerance.SLDPRT
Prototype/Parts/Track parts/Alex's Track 2.SLDPRT
Prototype/Parts/Top layer parts/compartment door - No tolerance.SLDPRT
Prototype/Parts/Track parts/Belt1-3.SLDPRT
Prototype/Parts/Top layer parts/raspberry-pi-camera-3.snapshot.2/OVA5647.SLDPRT
Prototype/Parts/Top layer parts/raspberry-pi-camera-3.snapshot.2/RasPi_Camera.IGS
Prototype/Parts/Top layer parts/raspberry-pi-camera-3.snapshot.2/RasPi_Camera.SLDASM
Prototype/Parts/Track parts/Old parts/Alex's Track 2.SLDPRT
Prototype/Parts/Track parts/Old parts/Belt1-1.SLDPRT
Prototype/Parts/Track parts/Old parts/Belt1-3.SLDPRT
Prototype/Parts/Track parts/Old parts/Box for Tracks.SLDASM
Prototype/Parts/Track parts/Old parts/Idler v.1.1.SLDPRT
Prototype/Parts/Track parts/Old parts/Idler.SLDPRT
Prototype/Parts/Track parts/Old parts/Roller.SLDPRT
Prototype/Parts/Track parts/Old parts/Sprocket - No tolerance.SLDPRT
Prototype/Parts/Track parts/Old parts/Sprocket 4.SLDPRT
Prototype/Parts/Track parts/Old parts/Sprocket1.SLDPRT
Prototype/Parts/Track parts/Old parts/Sprocket2.SLDPRT
Prototype/Parts/Track parts/Old parts/trial side.SLDPRT
