chenshih881001/Life-Frog/System engineering/Paper design/Oscar/sketch.pdf

# First sketch

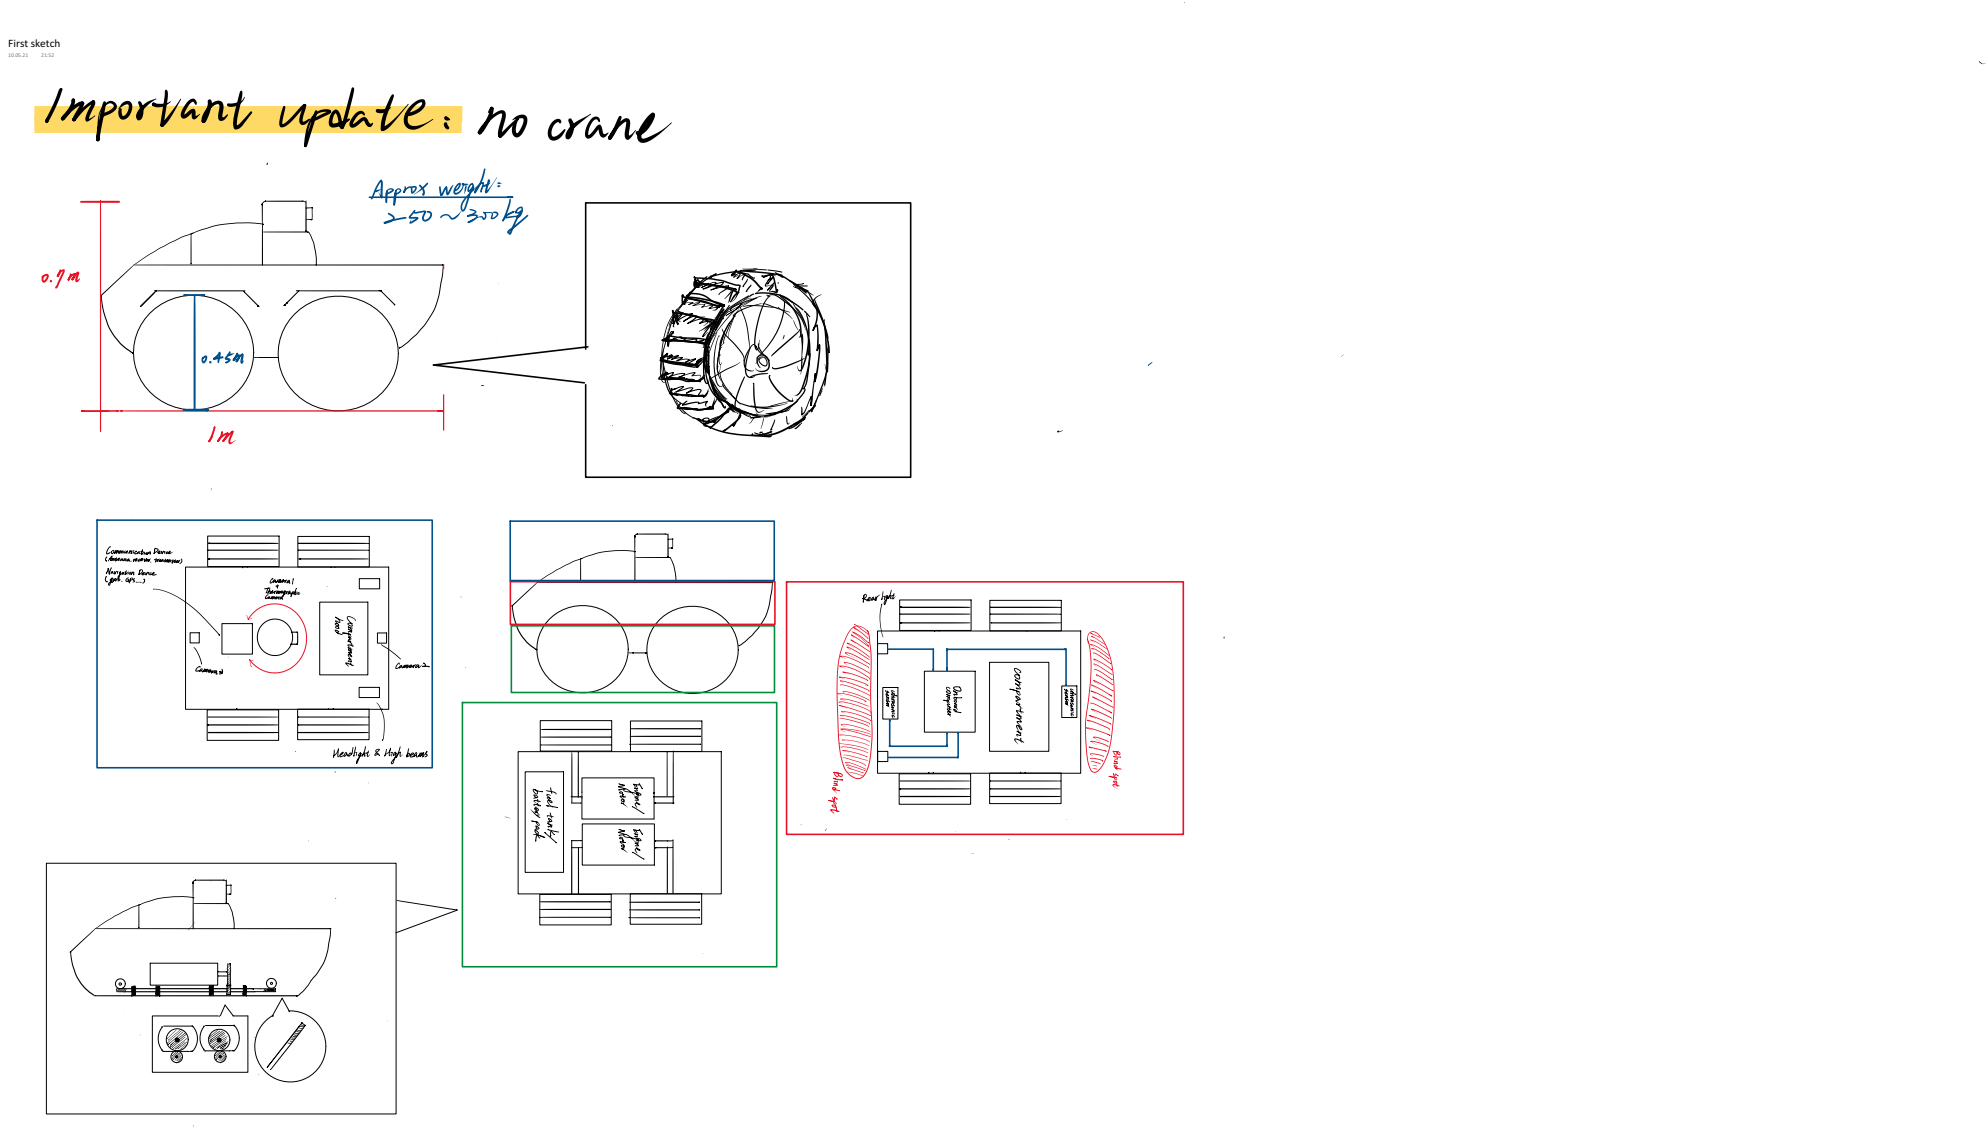
[picture p112: page 1]
