chenshih881001/Life-Frog/(commit log)

2021-04-11 Create Use-case Crane,ladders.png
2021-04-11 Create Use-case Explorer robot.png
2021-04-11 Create Use-case Remote control.png
2021-04-16 Create Lifefrog - task list.xlsx
    [Lifefrog - task list.xlsx]
2021-04-16 use-case diagrams correction
2021-04-18 Update Lifefrog - task list.xlsx
    [Lifefrog - task list.xlsx]
2021-04-19 New use case diagram
2021-04-19 Update Lifefrog - use case diagram.png
2021-04-22 Create LifeFrog - ibd Drivetrain.png
2021-04-23 Update LifeFrog - ibd Drivetrain.png
2021-04-27 Create LifeFrog - IDB Diagram for Drivetrain.png
2021-05-19 added parts file
    [Roller.SLDPRT]
2021-05-19 roller and idler parts
    [Idler.SLDPRT, Roller.SLDPRT]
2021-05-19 Holder and sprocket update
    [Holder.SLDPRT, Sprocket.SLDPRT]
2021-05-19 fixed idler hole
    [Idler.SLDPRT]
2021-05-19 fixed holes
    [Roller.SLDPRT]
2021-05-19 Create trial side.SLDPRT
    [trial side.SLDPRT]
2021-05-19 stuff 2
    [Idler.SLDPRT, Roller.SLDPRT]
2021-05-21 Sprocket update
    [Sprocket Cap.SLDPRT, Sprocket1.SLDPRT]
2021-05-21 Update Sprocket Cap.SLDPRT
    [Sprocket Cap.SLDPRT]
2021-05-21 Some update and fixes
    [Idler.SLDPRT, Roller.SLDPRT, Sprocket Cap.SLDPRT, Sprocket and cap.SLDASM, Sprocket1.SLDPRT, trial side.SLDPRT]
2021-05-21 testing testing
    [Holder.SLDPRT, Idler.SLDPRT, Roller.SLDPRT, Sprocket1.SLDPRT, trial side.SLDPRT]
2021-05-22 changed idler and roller design
    [Idler v.1.1.SLDPRT, Idler v.1.2.SLDPRT, Idler.SLDPRT, Roller v.1.2.SLDPRT, Roller.SLDPRT, trial side.SLDPRT]
2021-05-23 add compartment
    [door.SLDPRT, top.SLDPRT]
2021-05-24 fixed shaft holes
    [Idler v.1.2.SLDPRT, Roller v.1.2.SLDPRT]
2021-05-24 fixed stuff
    [Idler v.1.2.SLDPRT, Roller v.1.2.SLDPRT]
2021-05-24 Update Box for Tracks.SLDASM
    [Box for Tracks.SLDASM]
2021-05-24 Update Holder final Opposite.SLDPRT
    [Holder final Opposite.SLDPRT]
2021-05-24 update top
    [door.SLDPRT, top2.SLDPRT]
2021-05-24 Final tracks 1
    Alex's stuff
    [A Belt.SLDPRT, Alex Thing.SLDASM, Alex's Track.SLDPRT, Belt1-1.SLDPRT, Belt1-3.SLDPRT, Holder final.SLDPRT, Sprocket 4.SLDPRT, Sprocket Final.SLDPRT]
2021-05-24 compartment stuffs
    [AssemCompartment.SLDASM, door.SLDPRT]
2021-05-25 Create Compartment making.SLDASM
    [Compartment making.SLDASM]
2021-05-25 Update Box.SLDPRT
    Added Ultrasonic Sensor holes
    [Box.SLDPRT]
2021-05-25 Update Box.SLDPRT
    Add mounting nutholder
    [Box.SLDPRT]
2021-05-25 Create Hood + Mic + Cam.SLDASM
    [Hood + Mic + Cam.SLDASM]
2021-05-26 Update Layer-2_Mounting.SLDPRT
    made it smaller and should fit now
    [Layer-2_Mounting.SLDPRT]
2021-05-26 Update to platform
    [1_Layer.SLDASM, Layer-2_Mounting.SLDPRT]
2021-05-26 Update Layer-2_Mounting.SLDPRT
    added cable hole
    [Layer-2_Mounting.SLDPRT]
2021-05-26 Update to box
    [1_Layer.SLDASM, Belt1-3.SLDPRT, Box for Tracks.SLDASM, Box.SLDPRT, Layer-2_Mounting.SLDPRT]
2021-05-26 Update Box.SLDPRT
    added pins for the ultrasonic sensor
    [Box.SLDPRT]
2021-05-26 increased hole tolerance
    [Idler v.1.2.SLDPRT, Roller v.1.2.SLDPRT]
2021-05-26 Update of updates
    [1_Layer.SLDASM, Assem3.SLDASM, Box.SLDPRT, Holder final Opposite.SLDPRT, Holder final.SLDPRT, Hood + Mic + Cam.SLDASM, Hood with Tolerence.SLDPRT, Hood.SLDPRT]
2021-05-26 Hopefully final update
    [1_Layer.SLDASM, Assem3.SLDASM, Box.SLDPRT, Hood + Mic + Cam.SLDASM]
2021-05-26 Last Last One - hopefully
    [Compartment.SLDPRT]
2021-05-27 Last last update, hopefully
    [10. Hood.STEP, 11. Compartment.STEP, 12. Compartment door.STEP, 1_Layer.SLDASM, 2. Holder Left.STEP, 3. Holder Right.STEP, 4. Idler.STEP, 5. Roller.STEP]
2021-05-28 Small update
    [1_Layer.SLDASM, 4. Idler.STEP, 5. Roller.STEP, Assem3.SLDASM, Hood + Mic + Cam.SLDASM, Idler v.1.2.SLDPRT, OVA5647.SLDASM, OVA5647.SLDPRT]
2021-05-28 Create Axle Bearing.SLDPRT
    [Axle Bearing.SLDPRT]
2021-05-28 Added thrust bearings
    [1_Layer.SLDASM, Assem3.SLDASM, Final Track.SLDPRT, Hood + Mic + Cam.SLDASM, Part list.xlsx, Roller v.1.2.SLDPRT]
2021-05-28 Update Part list.xlsx
    [Part list.xlsx]
2021-06-22 Update robot_Lifefrog_P.c
    world2 will be cleared every new target (added XtargetOld and YtargetOld)
    world2 will only update new found stuff (so it wont mess up its own footprints)
    4 failures left
